GBK-com/Delumenyu/小型偏心柱塞泵/FINAL_REPORT.md

# 小型偏心柱塞泵 —— 最终交付报告

2026-11-02 12:30 · Lead + 4 个子智能体并行交付
（本文件取代 `DELIVERY.md`，是最新且唯一有效的交付说明）

---

## 一、总览：全部完成

| 交付项 | 状态 |
|---|---|
| SolidWorks 零件建模（8 类） | ✅ **完成**，逐件体积/包围盒/关键面实测回读 |
| 完整装配（16 组件） | ✅ **完成**，三柱塞位置与运动学表逐位吻合 |
| 干涉检查 | ✅ **完成**，真设计干涉 **0 项** |
| 运动仿真 | ✅ **完成**，SW 原生 Motion Study 已求解 |
| AutoCAD 全套工程图（4 张） | ✅ **完成**，每张 finalize 92 分/B，回归 48/48 全绿 |

---

## 二、液力参数（设计值）

3 柱塞径向 120° 均布 · 柱塞 Ø12 · 偏心 e₁=2.5 → 行程 **5.000** · 排量 **1.696 mL/r**（对外 1.70）
n=1450 r/min → 理论流量 **2.460 L/min** · 额定 10 MPa · 轴功率 **0.482 kW**（配 0.55 kW）
流量脉动系数 δq ≈ **7.18%** · 外形 **Ø104 × 74**

---

## 三、零件清单（全部实测，sha256 前 16 位）

| 件号 | 名称 | 体积 mm³ | box mm | sha256 | 关键实测 |
|---|---|---|---|---|---|
| BP-01 | 泵体 ZL104 | 376,159.161523 | Ø104×56 | `63d0b4d7e82e2d92` | 3×Ø12.5@0/120/240→R48；3×Ø5@R26；2×M14@90°/270° z=40；6×M5 Ø4.2@Ø88 深16；1° 拔模；40 特征 0 错 |
| BP-02 | 偏心轴 45调质 | 26,474.290684 | 25.7×24×93 | `04f4e2ee92059c4a` | e₁ 实测 +2.500 / e₂ 实测 −1.200；两键槽 4×2.5；退刀槽 Ø13×2；37 特征 0 错 |
| BP-03 | 柱塞 GCr15 | 2,462.415505 | 12×12×29 | `ced2dc057a3f3ab5` | 球头 R5 + Ø12×18 + 环槽 Ø8.6×2.4 + Ø8×6 |
| BP-03b | 柱塞（装配朝向版） | 2,467.116843 | 12×12×29 | `2885eeb2f4f376e2` | **同一零件的另一种朝向**，用于配合定向；明细栏仍是一项 ×3 |
| BP-04 | 回程盘 45 | 46,957.427426 | 104×104×10.089 | `f8ecf160c09274e0` | 球冠 R40（r10 处凸 4.0888）；3×沉头 Ø5.5/Ø10@Ø88 + 3×Ø5.5 通孔@Ø88；槽 Ø70×3.8×2.4 |
| BP-05 | 配流盘 ZQSn6-6-3 | 19,501.866475 | 64×64×10 | `cf532b0a3cdabb11` | 腰型窗内R22.5/外R29.5、包角160°×2、岛20°×2 岛跨±X；Ø21×1 沉孔 |
| BP-06 | 端盖 ZL104 | 93,469.858619 | 104×104×12 | `eacee309a32b9b47` | Ø16H7；6×Ø5.5@Ø88；槽 Ø70×3.8×2.4；凹球座 R40 深 4.0888 |
| BP-07 | 弹簧 60Si2Mn | 284.244607 | 11.2×11.2×17 | `84ebdc55cac4f5b0` | 线径Ø1.2、中径Ø10、总圈8/有效6、自由长17、安装长13 |
| STD | O型圈67×3 | 1,554.462693 | 73×73×3 | — | 中径 Ø70 |
| STD | O型圈10×1.8 | 94.333679 | 13.6×13.6×1.8 | — | 柱塞密封 |
| STD | 螺钉M5×20 / M5×30 | 631.603273 / 827.952814 | — | — | 等效件 |

---

## 四、装配与干涉

**`PUMP_ASSY.sldasm`**（312,627 B，sha `5379e202bac9fc57`）—— 16 组件完整总装
**`PUMP_MOTION_study.sldasm`**（219,014 B，sha `036da6b8006b3b2f`）—— 运动版（凸轮耦合 + 旋转马达）

### 三柱塞位置 vs 运动学表（θ=0）
| 柱塞 | 实测 ρ | 实测方位 | 运动学期望 | 判定 |
|---|---|---|---|---|
| 0° | 19.500 | 0° | 19.500 | ✔ |
| 120° | 15.750 | 120° | 15.750 | ✔ |
| 240° | 15.750 | 240° | 15.750 | ✔ |

### 干涉检查：9 项，**真设计干涉 0**
| 项 | 体积 mm³ | 判定 |
|---|---|---|
| 3×M5×30 vs 泵体 | 279.53 | 螺纹名义干涉（等效件光杆 Ø5 进 Ø4.2 底孔），CAD 常规 |
| 3×M5×20 vs 泵体 | 221.40 | 同上 |
| O型圈67×3 ×2 vs 沟槽 | 221.32 | 设计压缩 0.6 mm，正常 |
| 回程盘 vs 端盖 | 0.005 | 球面座接触，可忽略 |

### 运动仿真
`MCP_旋转马达算例` · AEMRotationalMotor · 60 rpm · 时长 4.0 s · 马达 1 · **results_available=true, out_of_date=false**
运动版装配体干涉检查 **0 项**，球头相切于偏心轮（球心 ρ=19.5、球头最内点 14.5 = 凸轮表面）。
**在 SolidWorks 里打开 `PUMP_MOTION_study.sldasm`，切到「运动算例」点播放即可看到柱塞往复。**

---

## 五、工程图（4 张，全部 92 分/B，0 error）

| 图 | 图幅 | DWG / DXF / PDF | 真实尺寸 | 内容 |
|---|---|---|---|---|
| BP-00 装配图 | A1 1:1 | 48,688 / 349,764 / 160,244 | 5 | 主视图 + A-A 全剖（24 处真实 HATCH）+ 配流原理图 + 明细栏 12 行原生 TABLE + 11 项序号 + 技术要求原文 5 条 + 追加 2 条 |
| BP-01 泵体 | A3 1:1 | 30,721 / 159,300 / 125,662 | 10 | 主+俯+B-B 全剖，7 处剖面线，6 形位公差，Ra0.8×2/Ra3.2 |
| BP-02 偏心轴 | A3 1:1 | 29,157 / 156,902 / 123,082 | **18** | 9 段阶梯 + 两键槽 + 退刀槽 + 键槽断面 + 偏心轮端视图；**e=2.5±0.02 用真公差**（DIMTOL/DIMTP/DIMTM） |
| BP-05 配流盘 | A3 2:1 | 32,879 / 157,348 / 63,654 | 9 | 腰型窗真实 ARC（R22.5/R29.5、160°/20°）+ 剖视 + 5 形位公差 + Ra0.4 |

图层按 8 层规范（01轮廓粗/02轮廓细/03中心线/04虚线/05标注/06文字/07剖面线/08图框标题栏）
回归校验 `cad/verify_drawings.py`：**48 项通过 / 0 失败**

---

## 六、设计过程中查出并修掉的 12 条真缺陷

| # | 缺陷 | 后果 | 谁发现 |
|---|---|---|---|
| 1 | 中心腔 Ø30 装不下 Ø40 回程盘 | 装配装不进 | Lead |
| 2 | 配流孔 R19 落在 Ø44 腔壁内 | 泵不打油 | Lead |
| 3 | **配流窗 110°/70° 布局** | 120°/240° 柱塞**中途换向→憋压** | Lead（相位校验） |
| 4 | 端盖 Ø88 槽与 Ø92 螺栓孔重叠 2.55 | 六处破口 | sub-cad |
| 5 | **弹簧 Ø1.6/8圈 压并 16.96 > 最小工作 10.5** | **行程一半压死** | Lead（刚度校核） |
| 6 | **轴装回程盘几何无解** | 中心孔需 ≥Ø30 过凸轮，但沉头孔只能在 R9 拧进 Ø24 轮 | sub-rotor + sub-plunger 独立发现 |
| 7 | 偏心轮端面 M4 破出外圆 0.126 | 螺纹破口 | sub-rotor |
| 8 | **M5 底孔与油口同方位贯通** | 压力油窜入螺钉孔外漏 | sub-housing（−139.15 mm³ 定量） |
| 9 | **回程盘 Ø78 槽与自身沉头孔重叠 1.9** | 密封带被打穿 | sub-housing 提线索 + sub-plunger 五级印证 |
| 10 | **偏心轴 Ø20 伸进配流盘 Ø16.5 孔** | 86.805 mm³ 真干涉 | Lead（干涉检查） |
| 11 | 回程盘只有 3 孔、端盖 6 螺栓 | 3 颗螺钉穿实心铝 | Lead（装配发现） |
| 12 | 图纸柱塞按 ρ=17 画 | 球头插进偏心轮 2.5 mm（自绘干涉） | sub-cad |

---

## 七、偏差登记（详见 `DEVIATIONS.md`，共 13 条 + 本轮新增）

- **弹簧为 8 圈环形叠片，非真螺旋**：扫描内核不支持螺旋路径（`cad_sweep` 直管精确 22.62，1 圈螺旋仅 0.16 mm³；`cad_loft` 报 sections too dissimilar；FreeCAD 未安装）。**本地 SW 手工扫掠一次即可替换**，参数在 `DESIGN_SPEC.md §3.7`。
- **装配体中未绘出 3 个弹簧**：环形件无圆柱面，桥接器 `rotate` 失效无法定向。明细栏仍列 ×3，装配图已加声明。
- **SW 模型未赋材料**：桥接器无接口，`mass_kg` 无工程意义，材料走明细栏。
- **回程盘功能重定位**为壳体上端封压盘（轴装几何无解）。
- **客户技术要求第 1 条**「配流盘与柱塞球面配合面研磨」原文照抄，但本设计为端面配流、两者无直接配合面——**若客户本意是别的结构型式，需回退重议**。
- **注**：`pump\` 目录下 `BP01_housing_v2`、`BP06_endcover_v2`、`BP04_retainer_v2`、`BP05_portplate_v3`、`STD_oring_75x3`、`STD_screw_M4x10` 均为**过期中间件**，沙箱无删除权限，请手动清理。

---

## 八、文件清单

```
deliver/
├── sw/    15 个：8 类零件 + 柱塞装配朝向版 + 弹簧安装态 + 4 标准件 + 2 装配体
├── cad/   12 个：4 张图 × (DWG+DXF+PDF) + verify_drawings.py
└── doc/   DESIGN_SPEC.md(v1.3) / DEVIATIONS.md / KINEMATICS.md /
           portplate_geometry.md / RESULT_{housing,plunger,rotor,cad}.md
```

---

## 九、仍需客户拍板的两件事

1. **结构型式**：本设计为「径向柱塞 + 随轴旋转端面配流盘」。若原意是轴向柱塞（斜盘式）或其他型式，整套要重做。
2. **回程盘重构**是否接受（轴装几何无解 → 改壳体上端封压盘）。
