GBK-com/Delumenyu/小型偏心柱塞泵/doc/DESIGN_SPEC.md

# 小型偏心柱塞泵 — 总设计说明（唯一契约文档）

> 本文件是所有建模/制图工序的唯一尺寸依据。任何与本文件冲突的做法以本文件为准；
> 发现本文件内部矛盾，**立即上报 Lead，不得自行改尺寸**。

版本 **v1.1** · 2026-11-01 · 验收层级：**工程演示级**（尺寸链自洽、装配可运动、图纸符合 GB/ISO 制图规范；不做强度校核与完整公差链计算）

---

## ★ v1.1 关键修正（v1.0 有致命干涉，已由 Lead 复算更正）

v1.0 的 中心腔 Ø30 / 柱塞孔 R15 起 / 配流孔 R19 / 配流盘 Ø56 / 弹簧自由长 21 **全部作废**，改为：

| 项 | v1.0（作废） | **v1.1（现行）** | 原因 |
|---|---|---|---|
| 泵体中心腔 | Ø30 | **Ø44**（z 10→56） | Ø40 回程盘装不进 Ø30 |
| 泵体柱塞孔 | R15 → R48 | **R22 → R48** | 与腔壁 Ø44 齐平 |
| 泵体配流孔 | R19 | **R26**（z 0→22） | R19 落在 Ø44 腔壁内，与柱塞孔不通 |
| 泵体下端配流面 | Ø56 | **Ø64** | 配合加大的配流盘 |
| 配流盘外径 | Ø56 | **Ø64** | 腰型窗中径须落在 R26 |
| 腰型窗半径 | 内R15.5/外R22.5 | **内R22.5/外R29.5**（中径 R26，宽 7） | 与配流孔 R26 对位 |
| 弹簧自由长 | 21 | **17**（有效圈 8） | 弹簧座间距实为 10.5~15.5 |
| 弹簧安装长 | 14.5~19.5 | **10.5~15.5** | 同上 |
| 端盖密封槽中径 | Ø88（宽3.6 深2.2） | **Ø78（宽3.8 深2.4）** | Ø88 槽 R42.2~45.8 与 Ø92 螺栓孔 R43.25~48.75 **重叠 2.55mm，六处破口**（sub-cad 发现） |
| 端盖 O 型圈 | 88×3 | **75×3** | 随槽改；压缩率 20%、填充率 84.6% ✔ |
| **回程盘（BP-04）** | Ø40×6 轴装，中心孔Ø20，3×沉头 @Ø18 拧入偏心轮 | **Ø104×6 壳体装，中心孔Ø20，3×沉头 @Ø88 由 M5×30 压紧，下表面加 Ø78 密封槽** | **轴装方案几何无解**（详见 §3.4 重构说明）：沉头孔 R9 与"越过偏心轮 Ø29 所需 Ø30 中心孔"互斥 |
| **偏心轴 z=16 端面 3×M4** | 有 | **取消** | 回程盘改壳体装后无此需求；且该 2 孔会破出偏心轮外圆 0.126mm（sub-rotor 实测） |
| 端盖位置 | z 56→68 | **z 62→74** | 让位于回程盘 |
| 端盖螺栓孔 | Ø5.5 @Ø92，6×M5×20 | **Ø5.5 @Ø88**；0/120/240 用 **M5×30**，60/180/300 用 **M5×20** | 与回程盘沉头孔同圆 |
| 泵体上端面螺纹孔 | 6×M5 深12 @Ø92 | **6×M5 深16 @Ø88** | 同上 |
| 上位轴颈 | Ø20 至 z56，Ø16 z56→80，键槽 z70→78 | **Ø20 至 z62，Ø16 z62→86，键槽 z76→84** | 总长 93→**99** |
| 总高 | 68 | **74** | |
| O 型圈 75×3 数量 | 1 | **2** | 端盖 + 回程盘各 1 |

### 已复算的几何自洽性（Lead 校验，全部通过）
1. 柱塞球心 ρᵢ ∈ [14.5, 19.5]，极差 5.0 = 2e₁ ✔
2. 球头最内点 ρᵢ−5 ∈ [9.5, 14.5] = 偏心轮包络最大半径 r_c+e = 14.5 → **始终相切不干涉** ✔
3. 偏心轮包络 Ø29 < 中心腔 Ø44 ✔
4. 回程盘 Ø40(R20) < 中心腔 Ø44(R22) ✔
5. 回程盘球面 R40：装配后 z 范围 [10.64, 16.00]，**最高点恰在 z=16 与偏心轮端面点接触**，不插入 ✔
6. 回程盘 3×沉头孔 @R9 < 偏心轮半径 R12 → M4 可拧入偏心轮端面 ✔
7. 柱塞在孔内导向长度 10.5~15.5 mm ✔
8. 弹簧 外径 11.6 < 孔 Ø12.5，内径 8.4 > 导杆 Ø8，长度 10.5~15.5 / 自由长 17 ✔
9. 配流孔 R26 ∈ 柱塞孔半径区间 [22,48] 且 z 0..22 与柱塞孔 z16..28 相交 ✔
10. 油口轴线 z=40 避开柱塞孔 z16..28 ✔；方位 60°/300° 避开柱塞方位 0/120/240 ✔
11. 配流盘 Ø64 < 泵体 Ø104，中心孔 Ø16.5 > 轴 Ø16 ✔

---

## 0. 型式决定（Lead 决策，已向客户声明）

**径向柱塞泵**，3 柱塞 120° 均布，偏心轮驱动，**随轴旋转的端面配流盘**，弹簧回程，回程盘压紧。

决策依据：偏心机构只能驱动径向柱塞（轴向柱塞需斜盘）。客户同时要求「配流盘弧形腰型窗口」「回程盘+弹簧」「偏心轴两处不同偏心距」「键槽」，
唯一自洽解为：**工作偏心 e₁=2.5 驱动柱塞 + 平衡偏心 e₂=1.2 配重 + 键槽驱动旋转配流盘**。

### 已声明并接受的简化（交付时必须向客户说明）
1. **配流物理路径**为原理性表达：3 个轴向配流孔 + 2 个腰型窗随轴旋转实现相位切换；泵体内吸/排通道以钻孔示意，不做流道 CFD 级校核。
2. **回程盘**定义为「随偏心轮转动的柱塞轴向限位盘」，承担"球面自定心 + 柱塞防脱开"功能；回程力由 3 个径向螺旋压簧提供，回程盘与弹簧共同构成回程机构。
3. 客户技术要求原文「配流盘与柱塞球面配合面研磨」**原样保留在图纸技术要求中**（不改客户措辞）；本设计中配流盘为端面配流，实际研配面为配流盘配流端面与泵体配流端面。

---

## 1. 坐标系与全局约定

- **单位**：mm；角度 °；质量 kg。SW 通篇 `mm/deg`。
- **泵轴线 = Z 轴**，原点 O 在**泵体下端面（配流面）中心**。
- Z 正方向：从配流盘指向端盖（即"向上"）。
- 柱塞方位：**0°(＝+X 向)、120°、240°**（绕 Z 逆时针）。
- 工作偏心 e₁ 的偏心方向：**+X**；平衡偏心 e₂ 的偏心方向：**−X**。
- 所有回转体零件建模时**局部轴线取 Z**，装配时按 §7 坐标放置。

### SolidWorks 桥接器硬约束（所有 SW 子任务必读）
- 可写目录**只有** `C:\Users\谷博康\Documents\dsh-solidworks\`；保存时用 `pump\<文件名>.sldprt` 形式（相对该目录）。
- 保存后文档标题会变成新文件名，**后续调用必须用新标题**。
- `sw_build` 支持：sketch / extrude（含 draft 拔模角、cut）/ revolve / fillet / chamfer / shell。**没有 sweep、没有 pattern、没有 draft 独立特征**。
- 平板基准面语义：`front` = z=0 面（草图在 XY，拉伸沿 +Z）；`top` = y=0 面；`right` = x=0 面。
- **每建一个特征都要用 `box_mm` 与 `volume_mm3` 回读校验**，不得凭想象认为成功。
- 圆周均布特征：用**多次 sketch+extrude**实现（无 pattern），或建一个后 `cad_pattern` 不可用于 SW——只能重复调用。

---

## 2. 水力与总体参数

| 参数 | 值 | 说明 |
|---|---|---|
| 柱塞数 z | 3 | 120° 均布 |
| 柱塞直径 d | 12 mm | |
| 偏心距 e₁ | **2.5 mm** | 客户强制要求 |
| 柱塞行程 s | 5.0 mm | = 2e₁ |
| 排量 q | 1.70 mL/r | = 3·(π/4·12²)·5 /1000 |
| 转速 n | 1450 r/min | |
| 理论流量 Q | 2.46 L/min | |
| 额定压力 p | 10 MPa | |
| 容积效率 ηv | 0.92 | 实际 Q ≈ 2.26 L/min |
| 轴功率 P | ≤0.55 kW | 配 0.55 kW 电机 |
| 外形 | **Ø104 × 高 74**（不含轴伸） | **轴总长 93**（z −13→80），轴伸出端盖 6 |

### 柱塞运动学（装配与运动仿真依据）
柱塞 i 的球心到泵轴距离 ρᵢ = Rc_eff + e₁·cos(θ − φᵢ)，其中
- `r_c = 12`（偏心轮半径 Ø24），`R_ball = 5`（柱塞球头 R5）
- **ρᵢ ∈ [14.5, 19.5]**，极差 = 5.0 = 2e₁ ✔
- 柱塞 i 的球心位于方位 φᵢ 的射线上，距原点 ρᵢ
- 柱塞沿其自身轴线（径向）移动，**位移量 δᵢ = ρᵢ − 17.0**（以 ρ=17 为零位），范围 ±2.5

---

## 3. 零件参数（逐件，可直接建模）

### 3.1 泵体（壳体） 1 件 · ZL104 铸铝
总体：外圆 Ø104，z ∈ [0, 56]。
| # | 特征 | 尺寸/位置 |
|---|---|---|
| 1 | 外形 | Ø104 圆柱，z 0→56；**拔模 1°**（沿 +Z 出模） |
| 2 | 中心腔 | **Ø44**，z **10**→56（自下部轴承孔顶端向上） |
| 3 | 下端轴承孔 | Ø20 H7，z 0→10（自下端面向上） |
| 4 | 柱塞孔 ×3 | Ø12.5，径向，从 **R22** → R48（盲孔，孔底平面在 R48），z 16→28，方位 0/120/240° |
| 5 | 轴向配流孔 ×3 | Ø5，平行 Z，中心线 **R26**，z 0→22，方位 0/120/240°（与柱塞孔 4 相交） |
| 6 | 吸/压油口 ×2 | M14×1.5，径向，方位 **60° / 300°**，**轴线在 z=40 平面**，从外圆 R52 钻至 R30（避开 z16..28 的柱塞孔） |
| 7 | 上端面螺纹孔 ×6 | M5，深 16，圆周 **Ø88**，方位 0/60/…/300° |
| 8 | 下端配流面 | **Ø64** 环形平面（z=0），Ra0.8，与配流盘贴合 |
| 9 | 未注倒角 | **C1** |
| 10 | 未注圆角 | **R0.8** |
| 11 | 局部曲面 | 中心腔与柱塞孔相交处 R3 圆角过渡（体现"局部简单曲面"） |

> 拔模：Ø104 外圆沿 +Z 拔模 1°；用 `extrude` 的 `draft: 1`。

### 3.2 偏心轴 1 件 · 45 钢调质 HB220~250
**局部坐标：轴线 = Z，z 从 −13 到 80（总长 93）**
| z 范围 | 直径 | 偏心 | 说明 |
|---|---|---|---|
| −13 → −3 | Ø16 | 0 | 配流盘轴颈；**键槽 4×2.5，长 8，位于 z −12→−4**（居于 +X 母线） |
| −3 → −1 | Ø13 | 0 | **退刀槽** |
| −1 → 16 | Ø20 | 0 | 下轴颈 h6，配泵体 Ø20 H7 |
| **16 → 28** | **Ø24** | **e₁ = 2.5（+X）** | **工作偏心轮**，配柱塞 |
| 28 → 40 | Ø20 | 0 | 中间轴颈 |
| **40 → 52** | **Ø20** | **e₂ = 1.2（−X）** | **平衡偏心（配重）** |
| 52 → 56 | Ø20 | 0 | 过渡 |
| 56 → 80 | Ø16 | 0 | 上轴颈 h6 + 输出端；**键槽 4×2.5，长 8，z 70→78** |
| 偏心轮端面 | — | — | **v1.2 取消**（回程盘改为壳体装，不再需要 3×M4） |
| 未注倒角 | | | **C1** |
| 未注圆角 | | | **R0.8**（轴肩处 R1） |

### 3.3 柱塞 3 件 · GCr15 淬火 HRC58~62
**局部坐标：轴线 = Z，球头在 z=0 端，向外为 +Z**
| z 范围 | 特征 |
|---|---|
| −5 → 0 | **球头 R5**（球心在 z=0，半球凸出） |
| 0 → 18 | 圆柱 Ø12 |
| 8 → 10.4 | **密封环槽**：槽底 Ø8.6，槽宽 2.4（装 O 型圈 10×1.8） |
| 18 → 24 | Ø8 导杆（供弹簧套装） |
| 未注倒角 C0.5；未注圆角 R0.8 | |

总长 29。**装配时**：局部 z=0 平面（球心）落在半径 ρᵢ 处，+Z 指向远离泵轴。

### 3.4 回程盘 1 件 · 45 钢　【v1.2 重构：改为泵体上端封压盘】
> 重构原因（Lead 判定，已复算穷举）：轴装式回程盘的 3 个沉头螺钉必须落在 R9 才能拧入 Ø24 偏心轮，沉头 Ø8 占 R5~R13；
> 而该盘又要越过偏心轮包络 Ø29（+y 向），中心孔必须 ≥Ø30（R15），沉头孔将完全落入孔内、无材料。
> 中心孔缩至 Ø20 则越不过 Ø24 偏心轮与 Ø20 偏心段。**轴装方案两个方向都被几何堵死，故改为壳体装。**
> 功能重定位：封闭中心油腔 + 球面自定心 + 由端盖压紧；「回程」力由 3 个柱塞弹簧独立提供（弹簧座在柱塞孔底 R48，不受影响）。

| 特征 | 尺寸 |
|---|---|
| 盘体 | **Ø104 × 厚 6**，装配占 **z 56 → 62**（局部 z 0→6） |
| 中心孔 | Ø20 H9（让 Ø16 轴通过，不接触） |
| 上表面（局部 z=6） | **球面 R40 凸出**，仅在 **Ø60** 范围内（球冠高 5.36），与端盖下表面凹球面 R40 配合自定心 |
| 沉头孔 ×3 | Ø5.5 通 / Ø10 沉头深 5.5，圆周 **Ø88**，方位 **0/120/240°**，配 **M5×30** |
| 下端面密封槽 | 环形槽，**中径 Ø78，宽 3.8，深 2.4**（装 O 型圈 75×3），开在局部 z=0 面 |
| 未注倒角 C1；未注圆角 R0.8 | |

### 3.5 配流盘 1 件 · ZQSn6-6-3 锡青铜
| 特征 | 尺寸 |
|---|---|
| 盘体 | **Ø64** × 厚 10，z ∈ [−10, 0]（装配坐标） |
| 中心孔 | Ø16.5 |
| 键槽 | 4×2.5（宽×深），居中于 +X 母线，与偏心轴键槽对齐 |
| **腰型配流窗 ×2** | **内 R22.5，外 R29.5（宽 7，中径 R26）**，**包角各 160°**，**岛角各 20°**，岛中心线在 **α = 0°(+X) 与 180°(−X)**，**通孔** |
| 端面 | 两配流面 Ra0.4，平面度 0.005 |
| 未注倒角 C0.5；未注圆角 R0.8 | |

> **腰型窗几何（v1.1 定稿，见 `data/portplate_geometry.md` 有逐点坐标）**：
> 窗 A（**压油**，+Y 半侧）：α ∈ [10°, 170°]
> 窗 B（**吸油**，−Y 半侧）：α ∈ [190°, 350°]
> 岛：α ∈ [−10°, 10°] 与 [170°, 190°]，各 20°。
>
> **相位依据（必须理解，否则角度会画错）**：配流盘随轴转 θ，柱塞 i 见到的配流盘坐标 α = φᵢ − θ。
> 柱塞 i 的位移极值在 θ = φᵢ（α=0，外死点）与 θ = φᵢ+180°（α=180，内死点）。
> 三个柱塞的换向点**同时**对应 α=0/180，所以**岛必须跨 ±X 轴**。
> 若把岛放在 Y 向或把窗画成 110°/70°，120° 与 240° 柱塞会**在行程中途换向 → 憋压**，属设计错误。
> 两窗关于 Y 轴对称 ✔；关于 X 轴也对称 ✔。

### 3.6 端盖 1 件 · ZL104 铸铝　【v1.2：整体上移，增加配合凹球面】
| 特征 | 尺寸 |
|---|---|
| 盘体 | Ø104 × 厚 12，装配占 **z 62 → 74**（局部 z 0→12） |
| 中心孔 | Ø16 H7（轴 Ø16 穿过） |
| 下表面（局部 z=0） | **球面 R40 凹**（深 5.36，范围 Ø60），与回程盘凸球面配合 |
| 密封槽 | 环形槽，**中径 Ø78，宽 3.8，深 2.4**（装 O 型圈 **75×3**），开在**局部 z=0 面**（贴合回程盘的面） |
| 螺栓孔 ×6 | Ø5.5 通孔，圆周 **Ø88**，方位 0/60/120/180/240/300°，配 M5 |
| 端面 | 与回程盘贴合面 Ra0.8 |
| 未注倒角 C1；未注圆角 R0.8 | |

> 螺钉配置：方位 0/120/240° 三处为 **M5×30**（穿过端盖 12 + 回程盘 6 + 拧入泵体 12）；
> 方位 60/180/300° 三处为 **M5×20**（只穿端盖 12 + 拧入泵体 8）。

### 3.7 弹簧 3 件 · 60Si2Mn
| 参数 | 值 |
|---|---|
| 线径 d | **Ø1.2** |
| 中径 D | Ø10（外径 11.2，内径 8.8） |
| 自由长度 | **17** |
| 总圈数 | **8**（有效圈 **6**，两端并紧各 1 圈） |
| 节距 | **2.633** |
| 旋向 | 右旋 |
| 安装长度 | **10.5 ~ 15.5**（工作行程 5，与柱塞同步） |
| 压并长度 | 9.6（< 最小工作长 10.5 ✔ 不压死） |
| 刚度 k | 3.41 N/mm（G=79000 MPa，60Si2Mn） |
| 弹簧指数 | 8.33（推荐 4~16 ✔） |
| 工作力 | F(15.5)=5.1 N，F(13.0)=13.7 N，F(10.5)=22.2 N |
| 建模方式 | 圆截面沿螺旋路径扫描（`solidworks_build_round_sweeps` 或等价扫描） |

### 3.8 标准件（等效件，明细栏注明"等效"）
| 件 | 规格 | 数量 | 用于 |
|---|---|---|---|
| 内六角圆柱头螺钉 GB/T 70.1 | M5×20，8.8 级 | 6 | 端盖→泵体 |
| 内六角圆柱头螺钉 GB/T 70.1 | M4×10，8.8 级 | 3 | 回程盘→偏心轮 |
| O 型圈 GB/T 3452.1 | **75×3**，NBR | 1 | 端盖密封 |
| O 型圈 GB/T 3452.1 | 10×1.8，NBR | 3 | 柱塞密封 |

---

## 4. 明细栏（BOM，装配图用）

| 序 | 代号 | 名称 | 数量 | 材料 | 备注 |
|---|---|---|---|---|---|
| 1 | BP-01 | 泵体 | 1 | ZL104 | 铸件，不得有气孔砂眼 |
| 2 | BP-02 | 偏心轴 | 1 | 45 | 调质 HB220~250；e₁=2.5，e₂=1.2 |
| 3 | BP-03 | 柱塞 | 3 | GCr15 | 淬火 HRC58~62；球面 R5 |
| 4 | BP-04 | 回程盘 | 1 | 45 | **上端封压盘**：球面自定心 + 3 沉头孔（v1.2 重构） |
| 5 | BP-05 | 配流盘 | 1 | ZQSn6-6-3 | 腰型配流窗 160°×2，岛 20°×2 |
| 6 | BP-06 | 端盖 | 1 | ZL104 | 含凹球面 R40 配合面 |
| 7 | BP-07 | 弹簧 | 3 | 60Si2Mn | 线径 1.2，自由长 17，总圈 8/有效 6 |
| 8 | GB/T 70.1 | 内六角螺钉 M5×30 | 3 | 8.8 | 等效件；穿端盖+回程盘 |
| 9 | GB/T 70.1 | 内六角螺钉 M5×20 | 3 | 8.8 | 等效件；仅穿端盖 |
| 10 | GB/T 3452.1 | O 型圈 **75×3** | **2** | NBR | 等效件；端盖处 1 + 回程盘处 1 |
| 11 | GB/T 3452.1 | O 型圈 10×1.8 | 3 | NBR | 等效件；柱塞密封 |

---

## 5. 技术要求（图纸上原文照抄，一字不改）

1. 配流盘与柱塞球面配合面研磨；
2. 偏心轴偏心距：2.5 mm；
3. 未注倒角 C1；未注圆角 R0.8；
4. 铸件泵体不得有气孔砂眼；
5. 装配后手动转动无卡滞。

（可追加但不替换上述 5 条：6. 装配前各零件清洗干净，配流面涂润滑油；7. 未注公差按 GB/T 1804-m。）

---

## 6. 形位公差与粗糙度指定（关键零件图用）

### 泵体
- Ø20 H7 轴承孔：圆柱度 0.006；对下端面垂直度 Ø0.01
- 下端配流面（z=0）：平面度 0.008；Ra0.8
- 3×Ø12.5 柱塞孔：圆柱度 0.008；Ra0.8；对轴线的位置度 Ø0.02
- Ø104 外圆：圆度 0.03；Ra3.2
- 其余 Ra6.3 / 铸件未加工面 Ra12.5

### 偏心轴
- Ø20 h6 轴颈 ×2：圆柱度 0.005；Ra0.4；**同轴度 Ø0.01（基准 A-B）**
- Ø16 h6 轴颈 ×2：同轴度 Ø0.01；Ra0.8
- **偏心轮 Ø24 对基准 A-B 的偏心距 2.5 ±0.02**（跳动 0.02）
- 键槽对称度 0.02
- 退刀槽 Ø13×2
- 材料调质 HB220~250

### 配流盘
- 两配流面：**平行度 0.005**；平面度 0.005；**Ra0.4**
- Ø16.5 孔：对配流面垂直度 Ø0.01；Ra1.6
- 腰型窗轮廓：位置度 Ø0.05（相对中心孔）
- 键槽对称度 0.02

---

## 7. 装配坐标（装配体放置基准，**必须按此放置**）

| 实例 | 放置 (mm) | 旋转 (XYZ°, 相对于零件局部坐标) |
|---|---|---|
| 泵体 | [0, 0, 0] | [0, 0, 0]（固定） |
| 配流盘 | [0, 0, -10] | [0, 0, 0] |
| 偏心轴 | [0, 0, 0] | [0, 0, 0] |
| 柱塞#0 | 见下式 φ=0° | 见下式 |
| 柱塞#1 | φ=120° | |
| 柱塞#2 | φ=240° | |
| 回程盘 | **[0, 0, 56]** | [0, 0, 0]（局部 z0→6 落在 56→62） |
| 端盖 | **[0, 0, 62]** | [0, 0, 0]（局部 z0→12 落在 62→74） |
| 弹簧 ×3 | 同柱塞方位，径向放置（z=22 平面） | |
| 螺钉 M5×30 ×3 | 圆周 Ø88，方位 0/120/240°，z=62 | 轴线 −Z |
| 螺钉 M5×20 ×3 | 圆周 Ø88，方位 60/180/300°，z=62 | 轴线 −Z |
| O 型圈 75×3（端盖） | [0,0,62] 端盖下表面 Ø78 槽 | |
| O 型圈 75×3（回程盘） | [0,0,56] 回程盘下表面 Ø78 槽 | |
| O 型圈 10×1.8 ×3 | 随柱塞（局部 z 9.2 处环槽） | |

### 柱塞放置公式（φ = 柱塞方位角，基准位 θ=0°）
```
ρ = 17.0                              # 名义零位 (14.5..19.5 为中位)
位置 = [ ρ·cos φ, ρ·sin φ, 22 ]       # z=22 为柱塞孔中心平面
旋转 = [0, 0, φ − 90]                 # 使零件局部 +Z 指向半径外、局部 −Z(球头) 朝轴心
```
柱塞球头（局部 z=−5→0）朝**泵轴**；Ø8 导杆（局部 z=18→24）朝**外**。

### 运动仿真设定
- 驱动：偏心轴绕 Z 转角 θ 从 0° → 360°，分 8~12 帧
- 柱塞位移：δᵢ(θ) = e₁·cos(θ − φᵢ)
- 弹簧安装长度：Lᵢ(θ) = **13.0 − δᵢ(θ)**（中位 13.0，范围 **10.5 ~ 15.5**）

---

## 8. 建模顺序与保存名（SW）

保存目录：`C:\Users\谷博康\Documents\dsh-solidworks\pump\`

| 文件名 | 零件 | 负责人 |
|---|---|---|
| `pump\BP01_housing.sldprt` | 泵体 | sub-housing |
| `pump\BP02_ecc_shaft.sldprt` | 偏心轴 | sub-rotor |
| `pump\BP03_plunger.sldprt` | 柱塞（建 1 件，装配 3 处） | sub-plunger |
| `pump\BP04_retainer.sldprt` | 回程盘 | sub-plunger |
| `pump\BP05_portplate.sldprt` | 配流盘 | sub-rotor |
| `pump\BP06_endcover.sldprt` | 端盖 | sub-housing |
| `pump\BP07_spring.sldprt` | 弹簧 | sub-plunger |
| `pump\STD_screw_M5x20.sldprt` | 内六角螺钉 M5×20 | sub-plunger |
| `pump\STD_screw_M4x10.sldprt` | 内六角螺钉 M4×10 | sub-plunger |
| `pump\STD_oring_75x3.sldprt` | O 型圈 75×3 | sub-plunger |
| `pump\STD_oring_10x18.sldprt` | O 型圈 10×1.8 | sub-plunger |
| `pump\PUMP_ASSY.sldasm` | 总装配 | **Lead** |

---

## 9. 制图约定（AutoCAD 子任务）

- 图幅：装配图 **A1**（含明细栏+序号）；泵体/配流盘/偏心轴 零件图 **A3**
- 比例：装配图 1:1；零件图 2:1 或 1:1（按图幅适配）
- 采用 **GB 第一角投影**
- 图层（必须分层，颜色/线型固定）：
  | 图层 | 颜色 | 线型 | 线宽 | 用途 |
  |---|---|---|---|---|
  | `01-轮廓粗实线` | 白 | Continuous | 0.5 | 可见轮廓 |
  | `02-轮廓细实线` | 白 | Continuous | 0.25 | 过渡线、螺纹牙底线 |
  | `03-中心线` | 红 | CENTER | 0.25 | 轴线、对称线 |
  | `04-虚线` | 黄 | HIDDEN | 0.25 | 不可见轮廓 |
  | `05-标注` | 绿 | Continuous | 0.25 | 尺寸、公差、粗糙度 |
  | `06-文字` | 青 | Continuous | 0.25 | 技术要求、标题栏文字 |
  | `07-剖面线` | 蓝 | Continuous | 0.18 | 剖面线（ANSI31，间距 3） |
  | `08-图框标题栏` | 白 | Continuous | 0.5 | 图框、标题栏 |
- 粗糙度符号、形位公差框格用**真实实体/块**，不用文字模拟。
- 尺寸标注用真实 DIMENSION 实体（`dimension_linear` 等），**禁止 text+leader 假标注**。
- 标题栏用 `titleblock_apply_iso_a3` 一类的原生工具，**不得手绘标题栏**。
