GBK-com/Delumenyu/小型偏心柱塞泵/DELIVERY.md

# 小型偏心柱塞泵 — 交付说明（含未完成项，如实登记）

生成时间：2026-11-01 23:20　│　执行方式：Lead + 4 个子智能体并行（sub-housing / sub-rotor / sub-plunger / sub-cad）

---

## 一、先给结论（诚实版）

| 交付项 | 状态 | 说明 |
|---|---|---|
| 8 类零件三维建模 | ✅ **完成** | 全部落盘，逐件体积/包围盒/关键面实测回读，sha256 留档 |
| 装配体 | ⚠️ **部分完成** | 壳体/轴/配流盘/回程盘/端盖/O 型圈/螺钉位置正确；**3 个柱塞的径向位置错误**（原因见 §4） |
| 干涉检查 | ⚠️ **分析完成，CAD 实检受限** | 解析间隙表全部通过；CAD 实检因柱塞错位无法作为有效判据 |
| 运动仿真 | ⚠️ **理论完成，SW 动态未完成** | 24 个转角的三柱塞位移/弹簧长度/配流状态全表已交付；SW Motion Study 无法驱动柱塞 |
| 工程图 | ⚠️ **1 / 4** | 配流盘图已完成（DWG+DXF+PDF）；装配图、泵体图、偏心轴图未完成 |
| 图层规范 / 技术要求 / 明细栏 | ✅ 已定义 | 规范写进 `DESIGN_SPEC.md` §9 与 §4/§5 |

**未完成的根因不是"没做"，是我用的 SolidWorks 桥接器（v0.2.1）有三项功能实测失效，见 §4。**

---

## 二、已完成的零件（全部实测回读，不是"看着像"）

| 件号 | 名称 | 体积 mm³ | 包围盒 mm | 关键实测 | sha256 前 8 位 |
|---|---|---|---|---|---|
| BP-01 | 泵体 | **376,159.161523** | Ø104×56 | 3×Ø12.5@0/120/240 至 R48；3×Ø5@R26；2×M14@90°/270°；6×M5 Ø4.2@Ø88 深16；1° 拔模；40 特征 0 错误 | `63d0b4d7` |
| BP-02 | 偏心轴 | **26,474.290684** | 25.7×24×93 | e₁ 实测 +2.500（Ø24）；e₂ 实测 −1.200（Ø20）；两键槽 4×2.5；退刀槽 Ø13×2；37 特征 0 错误 | `04f4e2ee` |
| BP-03 | 柱塞 | **2,462.415505** | 12×12×29 | 球头 R5 + Ø12×18 + 环槽(Ø8.6×2.4) + Ø8×6 导杆 | `ced2dc05` |
| BP-04 | 回程盘 | **47,385.076726** | 104×104×10.089 | 球冠 R40（r10 处凸 4.0888）；3×沉头 Ø5.5/Ø10@Ø88；密封槽 **Ø70**（实测槽底环面 835.664 = π(36.9²−33.1²)） | `ba4bea99` |
| BP-05 | 配流盘 | **19,618.731866** | 64×64×10 | 腰型窗实测 内弧 Ø45.000068 / 外弧 Ø58.999923、径向边 α=10/170/190/350°、包角 160°×2、岛 20°×2 | `4f27cb2d` |
| BP-06 | 端盖 | **93,469.858619** | 104×104×12 | Ø16H7；6×Ø5.5@Ø88；密封槽 **Ø70**（内壁 Ø66.2/外壁 Ø73.8/深 2.4）；凹球座 R40 实测深 4.0888 | `eacee309` |
| BP-07 | 弹簧 | **284.244607**（自由态）/ **284.244607**（安装态） | 11.2×11.2×**17**（自由）/ **13**（安装） | ⚠️ **8 圈环形叠片，非真螺旋体**，见 §5 D-01 | `84ebdc55` |
| 标准件 | 螺钉 / O 型圈 | M5×20: 631.60；M4×10: 261.42；O 型圈 67×3: **1,554.462693**；O 型圈 10×1.8: 94.33 | — | 全部参数化等效件 | — |

**液力参数**：3 柱塞、柱塞 Ø12、偏心 e₁=2.5 → 行程 **5.000**、排量 **1.696 mL/r**（取整 1.70）、n=1450 → 理论 **2.460 L/min**、10 MPa、轴功率 **0.482 kW**（配 0.55 kW）。
**流量脉动系数 δq ≈ 7.18%**（三柱塞正弦叠加）。

---

## 三、设计过程中查出并修掉的真实缺陷（这部分是本次交付最硬的价值）

设计书从 v1.0 一路改到 v1.3，**每一次改都是因为发现了一个会让人返工或让零件报废的错误**：

| # | 缺陷 | 后果（若不改） | 谁发现 | 修法 |
|---|---|---|---|---|
| 1 | 中心腔 Ø30 装不下 Ø40 回程盘 | 装配装不进去 | Lead | 腔改 Ø44，柱塞孔起点 R15→R22 |
| 2 | 配流孔 R19 落在 Ø44 腔壁内 | 配流孔与柱塞孔不连通，泵不打油 | Lead | 配流孔改 R26，配流盘 Ø56→Ø64 |
| 3 | **配流窗口 110°/70° 布局** | 120°、240° 柱塞**在行程中途换向 → 憋压**，泵会响会振 | Lead（相位校验） | 改 **160°/20°，岛跨 ±X 轴**，三柱塞换向严格落在死点 |
| 4 | 端盖 Ø88 密封槽与 Ø92 螺栓孔径向重叠 2.55 mm | 六处破口，密封全废 | sub-cad | 槽改小 + 螺栓孔统一到 Ø88 |
| 5 | 弹簧 Ø1.6/8 圈/自由长 17 | **压并长 16.96 > 最小工作长 10.5 → 行程走一半就压死** | Lead（刚度校核） | 线径改 Ø1.2、有效圈 6，压并 9.6 ✔ |
| 6 | **轴装式回程盘几何无解** | 中心孔 ≥Ø30 才能越过偏心轮包络 Ø29，但沉头孔只能在 R9 才能拧进 Ø24 偏心轮 → 两头夹死 | sub-rotor + sub-plunger 独立发现，Lead 穷举确认 | 回程盘改**壳体上端封压盘**，端盖上移 z62→74，总高 68→74 |
| 7 | 偏心轮端面 M4 分度圆 Ø18 破出外圆 0.126 mm | 螺纹破口 | sub-rotor | 该 3 孔整体取消 |
| 8 | **M5 底孔与油口同方位 60°/300° 贯通** | 压力油窜进螺钉孔，外漏 | sub-housing | 油口改 **90°/270°**；实测泵体 −139.15 mm³，质心回正到 (1.5e-5, 5e-6) 双轴对称 |
| 9 | **回程盘 Ø78 密封槽与自身 Ø10 沉头孔重叠 1.9 mm**（z 向） | 密封带被打穿 = 泄漏通道 | sub-housing 提线索，sub-plunger 定量 | 槽改 **Ø70**，O 型圈 75×3→**67×3**；泄漏当量 3×9.924 mm²×1.9 = **56.57 mm³** 五级印证闭合到 0.00 |
| 10 | R3 圆角（腔壁与柱塞孔相交处） | 几何上无收口位置（孔起点 R22 = 腔半径，两面相切） | sub-housing | 不做，写明理由，不改 R24（会连带改导向长度与配流孔位） |

---

## 四、未完成项与根因（桥接器能力边界，实测结论）

SolidWorks 桥接器 v0.2.1，以下三项**经受控实验证实失效**：

1. **`sw_assemble` 的 `rotate` 参数完全无效**
   实测：柱塞件以 `rotate:[90,0,0]` 与 `[0,90,0]` 分别插入，探针 `[300,0,15]` 均命中 Ø8 圆柱面（box z 18.5~23.5）——**零旋转**，件仍是轴向。
   ⇒ 无法把柱塞/弹簧/O 型圈摆到 120°、240° 径向。

2. **`concentric` 配合只能部分定向**
   用圆形边做同心配合，能把柱塞轴线转到径向（三个柱塞方位 0/120/240 均正确），但**方向符号与轴向滑动位置由求解器随机决定**：实测柱塞-1 被翻成球头朝外，且滑到孔底（球心半径 51.5，应在 19.5）。补 `distance` 配合因两面已重合，取点解析到同一零件而失败。

3. **无 `move`/`transform` 组件操作**，一旦放错无法修正，只能重建装配体。

**结论**：这台泵是**三柱塞 120° 径向**结构，而桥接器只能可靠放置轴向零件 ⇒ **完整的三维装配 + Motion Study 柱塞往复，在本工具链下不可达成**。这不是"没试"，是三条路都试到底并留下了实测证据。

### 补救路径（你手工 3 步可完成，或换带 API 的 SW 环境）
1. 打开 `pump\PUMP_ASSY.sldasm`，把 3 个 `BP03_plunger` 删除；
2. 手工插入 3 次柱塞，各自加「同心 + 距离 13/14.25/14.25」配合（方向朝内，球头贴偏心轮）；
3. 插入 3 个 `BP07_spring_inst`（安装长 13）与 3 个 `STD_oring_10x18`，同法定向；然后 Motion Study 加旋转马达 = 完成客户要的运动仿真。

---

## 五、偏差登记（详见 `DEVIATIONS.md`）

- **D-01 弹簧非真螺旋**：`cad_sweep` 直管精确（22.62 = π·0.36·20）但 1 圈螺旋只得 0.16 mm³、8 圈 1.30 mm³ → 该内核扫掠不接受离开起始平面的路径；`cad_loft` 33/65 截面两次均报 `sections too dissimilar`；FreeCAD 未安装；MCP 侧 sweep 工具 schema 无文档且曾卡死 SW。⇒ 交付 8 圈环形叠片（体积 284.24 与「8×单环 35.53」精确吻合）。**你本地手工扫掠一次即可替换，参数在 `DESIGN_SPEC.md §3.7`。**
- **D-02 模型未赋材料**：桥接器无赋材料接口，`mass_kg` 无工程意义，材料在明细栏标注。
- **D-03 未注 R0.8 未逐边实现**：避免吃掉键槽 4 mm 宽与孔口，按图纸技术要求由工艺保证。
- **D-05 回程盘功能重定位**：轴装方案几何无解（§3 第 6 条），改为壳体上端封压盘；回程力由 3 个柱塞弹簧独立提供。
- **D-06 客户技术要求第 1 条**：「配流盘与柱塞球面配合面研磨」**原文照抄进图纸**，但本设计为端面配流，两者无直接配合面——**若客户本意是别的结构型式，此条需回退重议**。

---

## 六、文件清单

```
deliver/
├── sw/          18 个 SLDPRT + 1 个 SLDASM（含中间版本 _v2，最终件见 §2 表）
├── cad/         BP05_配流盘.dwg / .dxf / .pdf（其余 3 张未完成）
└── doc/
    ├── DESIGN_SPEC.md        设计书 v1.3（含 v1.0→v1.3 全部修正记录）
    ├── DEVIATIONS.md         偏差与简化登记
    ├── KINEMATICS.md         柱塞运动学表（24 转角 × 三柱塞，含配流状态）
    ├── portplate_geometry.md 配流盘腰型窗逐点坐标 + 相位表
    └── RESULT.md             泵体/端盖建模验收记录（sub-housing）
```

---

## 七、我需要你拍板的三件事

1. **结构型式**：我按「径向柱塞 + 随轴旋转端面配流盘」定案。若你原意是轴向柱塞（斜盘式）或双作用，**整套设计要重做**——现在改比重做完再改便宜。
2. **回程盘重构**是否接受（轴装无解，改壳体装压盘）。
3. **弹簧**是否接受环形叠片近似（或你在本地 SW 手工扫掠一次）。

我可能错在哪：第 3 条的「径向是唯一自洽解」是我基于「偏心只能驱动径向柱塞」推的，但如果你手上已有现成的偏心柱塞泵图纸作为依据，以图纸为准，我按图纸重做。
