GBK-com/Delumenyu/小型偏心柱塞泵/HANDOFF.md

# 续做交接单（2026-11-01 收工 / 2026-11-02 补更两次）

---

## ★★ 2026-11-02 中午：总装做成并已存盘（最重要的里程碑）

**`pump\PUMP_ASSY.sldasm` · 312,627 B · sha256 `5379e202bac9fc571af7abc17f65baf894edaa1843093688a5f47b82243e27a2`**
16 个组件：泵体(固定) + 偏心轴(固定) + 3×柱塞 + 配流盘 + 回程盘 + 端盖 + 2×O型圈67×3 + 3×M5×30 + 3×M5×20。

### 三根柱塞位置：与 θ=0 运动学表逐位吻合
| 柱塞 | 装配坐标 | 实测 ρ | 方位 | 运动学期望 |
|---|---|---|---|---|
| 0° | (19.500, 0, 22) | 19.500 | 0° | 19.500 ✔ |
| 120° | (−7.875, 13.640, 22) | 15.750 | 120° | 15.750 ✔ |
| 240° | (−7.875, −13.640, 22) | 15.750 | 240° | 15.750 ✔ |

### 装配配方（**推翻昨晚"无解"结论的关键**，务必按序）
1. **先 `fix` 偏心轴**——否则相切配合会把**轴**拖走（实测被拖到 x=162.7）
2. 柱塞件用 **`BP03_plunger_b`**（球头在 +Z 端、机体向 −Z，体积 2467.117）——原版 `BP03_plunger` 会被同心配合翻成球头朝外
3. `concentric`：柱塞**肩部圆边** ↔ 泵体柱塞孔**盲端圆边** → 只定轴线，方向与滑动位置仍随机
4. `distance`：柱塞**肩部圆面**（取点要在 r 4~6 的圆环上，**不能取轴心**，否则取不到面）↔ 泵体**孔底面**，距离按行程给
   - θ=0 时：0° 柱塞 **10.5**，120°/240° 柱塞 **14.25**（= 48 − (ρ+18)）
   - 一条 distance 同时解决"在哪一侧"和"行程"两个自由度
5. 柱塞初始插入位置要放在**各自孔的正确一侧**（如 0°/120°/240° 方向半径 60 处），否则同心会把它甩到反侧

### 干涉检查结果：10 项，其中真缺陷 1 项
| 项 | 体积 | 判定 |
|---|---|---|
| 3×M5×30 vs 泵体 | 279.53 | 螺纹名义干涉（光杆 Ø5 进 Ø4.2 底孔），等效件固有，可接受 |
| 3×M5×20 vs 泵体 | 221.40 | 同上 |
| O型圈67×3 ×2 vs 沟槽 | 221.32 | 设计压缩 0.6 mm，正常 |
| **偏心轴 vs 配流盘** | **86.805** | **真缺陷，待修（见下）** |
| 回程盘 vs 端盖 | 0.005 | 球面接触，可忽略 |

**⚠ 唯一的真缺陷**：偏心轴 Ø20 段从 z=−1 起，而配流盘中心孔 Ø16.5 且占到 z=0，所以 z −1→0 有 1 mm 轴伸进孔里。
**修法（已派给 sub-rotor，SW 一恢复就能做）**：配流盘**上端面（局部 z=10）加 Ø21 沉孔、深 1**。预期体积 ≈19,486 ml（sub-rotor 提醒：因键槽与孔口倒角已占去约 16 mm³，实际会比 19,486.2 略高几 mm³，以实测为准）。

### 运动仿真状态
- MCP 侧**只有旋转马达、没有直线马达** → 柱塞要动必须靠**相切**耦合
- 相切与 distance 配合**互斥**（都是约束同一自由度），所以运动要在**另一个装配体**里做
- 已实测：柱塞初始放在正确一侧（半径 60 / 方位 0-120-240）后，三个 concentric 全部落在**正确一侧**（半径 42）✔ —— 这条是真突破，说明运动装配体可行
- 因 SW 崩溃，运动装配体（装配体4）未存盘，需重建

### 恢复工作后的顺序
1. 启动 SOLIDWORKS（bridge 不能自己起）
2. 让 sub-rotor 改配流盘（Ø21×1 沉孔）
3. 重开 PUMP_ASSY，替换配流盘为改后件 → 干涉复检 → 期望只剩「螺纹名义干涉 + O 型圈压缩」两类，**0 项真缺陷**
4. 建运动装配体：housing + shaft(fix) + 3×plunger_b(半径60处) → concentric → tangent → 加旋转马达 → 出运动结果
5. 出最后一张装配图 A1（sub-cad）

---

## ★ 2026-11-02 上午进展（按客户要求停工时的状态）

**图纸从 2/4 推进到 3/4：BP-02 偏心轴零件图已出**（`cad/BP02_偏心轴.dwg/.dxf/.pdf`，09:43 导出，29157/156902/123082 B）。
**唯一还缺：BP-00 装配图 A1。**

### 关键突破：柱塞径向定位的办法找到了（推翻昨天的"无解"结论）

| 步骤 | 做法 | 实测结果 |
|---|---|---|
| 1 | 重测 `rotate` | **确认彻底失效**——全新空装配体、`[0,90,0]`，柱塞杆仍在 z 18.5~23.5 → 不再浪费调用 |
| 2 | `concentric` + 圆形边定向 | **轴线方向能转对**（三柱塞方位 0/120/240 均正确），但**方向符号固定翻转**：球头被翻成朝外、且滑到孔底 |
| 3 | **换朝向重建模柱塞** | 球头建在 **+Z** 端、机体向 **−Z** 延伸（原版球头在 −Z）。文件 `pump\BP03_plunger_b.sldprt`，体积 **2467.117**（理论 2467.2 ✔），box 12×12×29 ✔，sha `2885eeb2f4f376e2…` |
| 4 | 用新件做同心配合 | **方向正确**：球头在 x 177~182（朝内），机体向 +X 到 206 |

**可复现的规律**：`concentric` 会让件产生一个固定方向的翻转；把零件按「翻转后正好正确」的朝向建模即可，不是撞运气。

### 恢复工作后从这里接（约 4 步，半天内能完）

1. 插入 **BP03_plunger_b**（×3，**不是** BP03_plunger）+ **BP02_ecc_shaft**
2. 每个柱塞 `concentric`：柱塞肩部圆边 ↔ 泵体柱塞孔盲端圆边 → 方向自动正确
3. 每个柱塞 `tangent`：球面 ↔ 偏心轮圆柱面 → **位置由偏心轮自己决定**，同时建立运动耦合（Motion Study 才能真正让柱塞往复）
   - ⚠️ 昨天踩过的坑：相切目标点 `[14.5,0,22]` 属**偏心轴**，轴没插入时会误配到泵体孔上。**先插轴，再加相切**
4. 干涉检查 → Motion Study 加旋转马达

### 三柱塞配合取点（装配坐标，θ=0）

| 柱塞 | 泵体孔盲端圆边 | 偏心轮表面 |
|---|---|---|
| 0° | `[48, 6.25, 22]` | `[14.5, 0, 22]` |
| 120° | `[-29.41, 38.44, 22]` | 待算（偏心轮方位 120° 处：`[2.5cos120+12cos120, 2.5sin120+12sin120, 22]`） |
| 240° | `[-18.59, -44.69, 22]` | 待算（同上，换 240°） |

另：柱塞插入时先放远处（如 `[200,0,0]`），配合会把它拉到位；放在泵体里会因初始干涉导致配合被拒。

---

# 原始交接单（2026-11-01 23:20 收工）

> **一句话状态**：8 类零件全部建模完成并逐件实测验收；工程图 4 张完成 2 张（配流盘、泵体）；
> **卡点是三维装配里 3 个径向柱塞摆不正**（SolidWorks 桥接器 `rotate` 参数实测失效）；装配图、偏心轴图未做。

---

## 一、续做时先读这四个文件（按顺序）

| 文件 | 作用 |
|---|---|
| `DELIVERY.md` | 交付状态总表 + 10 条设计缺陷的修复记录（最重要的工程资产） |
| `doc/DESIGN_SPEC.md` | **设计书 v1.3**，唯一尺寸依据。顶部有 v1.0→v1.3 的全部修正表 |
| `doc/DEVIATIONS.md` | 9 条偏差登记（弹簧、材料、R0.8 等） |
| `doc/KINEMATICS.md` | 柱塞运动学表（24 个转角 × 三柱塞位移/弹簧长度/配流状态） |

---

## 二、已完成件（sha256 前 16 位，均已落盘且 `dirty:false`）

| 文件 | sha256 | 体积 mm³ |
|---|---|---|
| `BP01_housing.sldprt`（泵体，v1.3 油口 90°/270°） | `63d0b4d7e82e2d92` | 376,159.161523 |
| `BP02_ecc_shaft.sldprt`（偏心轴） | `04f4e2ee92059c4a` | 26,474.290684 |
| `BP03_plunger.sldprt`（柱塞） | `ced2dc057a3f3ab5` | 2,462.415505 |
| `BP04_retainer_v2.sldprt`（回程盘，槽 Ø70，**以此为准**） | `ba4bea99f9262909` | 47,385.076726 |
| `BP05_portplate.sldprt`（配流盘） | `4f27cb2dfd1ff914` | 19,618.731866 |
| `BP06_endcover.sldprt`（端盖，槽 Ø70） | `eacee309a32b9b47` | 93,469.858619 |
| `BP07_spring.sldprt`（弹簧，自由长 17，8 圈叠片） | `84ebdc55cac4f5b0` | 284.244607 |
| `BP07_spring_inst.sldprt`（安装态，长 13） | — | 284.244607 |
| `STD_oring_67x3.sldprt` / `STD_oring_10x18` / `STD_screw_M5x20` / `STD_screw_M4x10` | — | 1,554.46 / 94.33 / 631.60 / 261.42 |
| `PUMP_ASSY.sldasm`（装配体，**柱塞位置待修**） | `c868d0714a84e202` | — |

⚠️ 作废件：`BP01_housing_v2`、`BP06_endcover_v2`、`BP04_retainer`（旧 Ø78 槽版）、`STD_oring_75x3`、`STD_screw_M4x10`、`_tmp_*`。**别用。**

---

## 三、图纸状态

| 图 | 状态 | 文件 |
|---|---|---|
| BP-05 配流盘零件图 A3 | ✅ 完成（finalize 92 分/B，腰型窗 160°/20° 真实 ARC + 剖视 + 6 处形位公差） | `cad/BP05_配流盘.dwg/.dxf/.pdf` |
| BP-01 泵体零件图 A3 | ✅ 完成（主视图+俯视图+B-B 全剖+7 处剖面线+11 个真实尺寸+6 形位公差+3 处 Ra） | `cad/BP01_泵体.dwg/.dxf/.pdf` |
| **BP-00 装配图 A1** | ❌ **未做** | — |
| **BP-02 偏心轴零件图 A3** | ❌ **未做** | — |

---

## 四、明天第一件事：修装配体的柱塞位置

### 卡点（已受控实验证实，别再试）
- `sw_assemble` 的 **`rotate` 参数完全失效**：`[90,0,0]` 与 `[0,90,0]` 两种都给零旋转（探针实测杆件仍在 z 18.5~23.5）。
- `concentric` 用圆形边可以定向（三柱塞方位已对），但**方向符号随机（会翻成球头朝外）、轴向位置随机（滑到孔底）**。
- 补 `distance` 配合失败：两面已重合，取点解析到同一零件。
- 无 `move`/`transform` 组件操作，放错只能重建。

### 三条可行路线（按推荐排序）
1. **手工修（最快，5 分钟）**：打开 `PUMP_ASSY.sldasm` → 删掉 3 个 `BP03_plunger` → 手工插入 3 次，各加「同心 + 距离」配合，方向朝内、球头贴偏心轮，距离取 **13 / 14.25 / 14.25**（对应 θ=0 时 ρ=19.5 / 15.75 / 15.75）。再插 3 个 `BP07_spring_inst` 与 3 个 `STD_oring_10x18`。然后 Motion Study 加旋转马达 → 柱塞往复即可演示。
2. **纯手算交付**：不要 SW 装配，直接用 `doc/KINEMATICS.md` 的 24 行表 + 8 张转角截图作为运动仿真证据。
3. **换环境**：用有 SW API（VBA/Python）的环境写循环改 `Component2.Transform2`，可全自动。

### 修好后要做的
- `sw_interference`（预期残留项只有三类，都能解释）：螺钉螺纹等效件与底孔的**名义**干涉、O 型圈压缩干涉、弹簧与孔底接触。
- `sw_bom` 核对明细栏 11 项。
- `sw_export` 出 STEP。

---

## 五、明天第二件事：补两张图

- **BP-02 偏心轴零件图 A3**：9 段阶梯（Ø16/13/20/24/20/20/20/16）+ 总长 93 + 两处键槽 4×2.5（z −12~−4、70~78）+ 退刀槽 Ø13×2 + 偏心轮端视图标 e₁=2.5±0.02。形位公差见 `DESIGN_SPEC.md §6`。
- **BP-00 装配图 A1**：主视图 + A-A 全剖 + 序号 11 项 + 明细栏 + 技术要求 5 条（原文照抄）+ 追加 2 条。可省柱塞方位剖视。

---

## 六、必须保留给客户的三件事（已在 DELIVERY.md §7）

1. 结构型式确认为「径向柱塞 + 随轴旋转端面配流盘」——若不是，整套要重做。
2. 回程盘重构（轴装无解 → 壳体上端封压盘）是否接受。
3. 弹簧为 8 圈环形叠片（非真螺旋）是否接受。

---

## 七、环境事实（明天别再踩）

- SW 桥接器**只能写** `C:\Users\谷博康\Documents\dsh-solidworks\`，工作区 `Desktop\sw` 写不进；`save_enabled=false`，覆盖源文件会被拒，需 `save-as _tmp → sw_export overwrite`。
- `sw_build` 只有 sketch/extrude/revolve/fillet/chamfer/shell/plane/delete：**无 sweep、无 pattern、无 move**。拔模用 extrude 的 `draft`。
- **revolve 的轴线只认水平/垂直**，120°/240° 的径向孔必须靠 `solidworks_pattern`（MCP 侧）圆周阵列。
- MCP 侧 `solidworks_build_round_sweeps` schema 无文档且曾令 SW 卡死 —— **别碰**。
- AutoCAD 2024 COM 在线，`mcp__autocad__` 247 个工具；`drawing_finalize` 是验收闸口，`drawing_critique` 必须在 finalize 前清空。
