GBK-com/Delumenyu/小型偏心柱塞泵/doc/portplate_geometry.md

# 配流盘 BP-05 腰型配流窗 — 最终几何（Lead 复算，v1.1 定稿）

单位 mm；原点 = 配流盘中心；+X = 0°，逆时针为正。
盘体 Ø64 × 10，中心孔 Ø16.5，键槽 4×2.5（+X 母线）。
腰型窗：内 R22.5，外 R29.5（径向宽 7，中径 R26）。
**包角各 160°，岛角各 20°，岛中心线在 α=0°(+X) 与 α=180°(−X)。**

## 相位依据（为什么岛必须跨 ±X 轴）
配流盘随轴转 θ，柱塞 i 在壳体方位 φᵢ，其见到的配流盘坐标 α = φᵢ − θ。
柱塞 i 的位移极值出现在 θ = φᵢ（外死点，α=0）与 θ = φᵢ+180°（内死点，α=180°）。
⇒ 三个柱塞的换向点**同时**落在 α=0 与 α=180，因此岛必须以 α=0/180 居中。
校验：φ=0/120/240 三条柱塞，两个死点均落在岛上，各留 10° 密封过渡。✔

## 窗 A（压油，+Y 半侧）α ∈ [10°, 170°]
- 内弧：起 `[22.1582, 3.9071]` → 中 `[0, 22.5]` → 止 `[-22.1582, 3.9071]`
- 外弧：起 `[29.0518, 5.1226]` → 中 `[0, 29.5]` → 止 `[-29.0518, 5.1226]`
- 径向边 1：`[22.1582, 3.9071]` → `[29.0518, 5.1226]`
- 径向边 2：`[-29.0518, 5.1226]` → `[-22.1582, 3.9071]`

内弧 10° 取样：
```
[[22.1582,3.9071],[21.1431,7.6955],[19.4856,11.25],[17.236,14.4627],[14.4627,17.236],[11.25,19.4856],[7.6955,21.1431],[3.9071,22.1582],[0,22.5],[-3.9071,22.1582],[-7.6955,21.1431],[-11.25,19.4856],[-14.4627,17.236],[-17.236,14.4627],[-19.4856,11.25],[-21.1431,7.6955],[-22.1582,3.9071]]
```
外弧 10° 取样：
```
[[29.0518,5.1226],[27.7209,10.0896],[25.5477,14.75],[22.5983,18.9622],[18.9622,22.5983],[14.75,25.5477],[10.0896,27.7209],[5.1226,29.0518],[0,29.5],[-5.1226,29.0518],[-10.0896,27.7209],[-14.75,25.5477],[-18.9622,22.5983],[-22.5983,18.9622],[-25.5477,14.75],[-27.7209,10.0896],[-29.0518,5.1226]]
```

## 窗 B（吸油，−Y 半侧）α ∈ [190°, 350°]
- 内弧：起 `[-22.1582, -3.9071]` → 中 `[0, -22.5]` → 止 `[22.1582, -3.9071]`
- 外弧：起 `[-29.0518, -5.1226]` → 中 `[0, -29.5]` → 止 `[29.0518, -5.1226]`
- 径向边 1：`[-22.1582, -3.9071]` → `[-29.0518, -5.1226]`
- 径向边 2：`[29.0518, -5.1226]` → `[22.1582, -3.9071]`

内弧 10° 取样：
```
[[-22.1582,-3.9071],[-21.1431,-7.6955],[-19.4856,-11.25],[-17.236,-14.4627],[-14.4627,-17.236],[-11.25,-19.4856],[-7.6955,-21.1431],[-3.9071,-22.1582],[0,-22.5],[3.9071,-22.1582],[7.6955,-21.1431],[11.25,-19.4856],[14.4627,-17.236],[17.236,-14.4627],[19.4856,-11.25],[21.1431,-7.6955],[22.1582,-3.9071]]
```
外弧 10° 取样：
```
[[-29.0518,-5.1226],[-27.7209,-10.0896],[-25.5477,-14.75],[-22.5983,-18.9622],[-18.9622,-22.5983],[-14.75,-25.5477],[-10.0896,-27.7209],[-5.1226,-29.0518],[0,-29.5],[5.1226,-29.0518],[10.0896,-27.7209],[14.75,-25.5477],[18.9622,-22.5983],[22.5983,-18.9622],[25.5477,-14.75],[27.7209,-10.0896],[29.0518,-5.1226]]
```

## 配流相位表（装配图配流原理图用）

| 柱塞方位 φ | 外死点 θ | 内死点 θ | 压油窗口 θ 区间 | 吸油窗口 θ 区间 |
|---|---|---|---|---|
| 0° | 0° | 180° | 10°–170° | 190°–350° |
| 120° | 120° | 300° | 130°–290° | 310°–110° |
| 240° | 240° | 60° | 250°–410°(=50°) | 70°–230° |

## 排量复核
d=12，s=2e=5，A=113.097 mm²；单柱塞 565.49 mm³；三柱塞 **1696.46 mm³ = 1.696 mL/r**（对外取整 1.70 mL/r）
n=1450 r/min → 理论流量 **2.460 L/min**；10 MPa、η=0.85 → 轴功率 **0.482 kW**（配 0.55 kW）

## 关键配合间隙表
| 配合 | 间隙/配合 mm | 说明 |
|---|---|---|
| 柱塞 Ø12 / 柱塞孔 Ø12.5 | 0.50 | H8/f7 间隙配合 |
| 柱塞导杆 Ø8 / 弹簧内径 Ø8.4 | 0.40 | 弹簧自由套入 |
| 弹簧外径 Ø11.6 / 孔 Ø12.5 | 0.90 | 无刮擦 |
| 轴 Ø16 / 配流盘孔 Ø16.5 | 0.50 | H8/f7 滑动 |
| 轴 Ø20 h6 / 泵体 Ø20 H7 | 0.020~0.041 | 间隙配合 |
| 回程盘 Ø40 / 中心腔 Ø44 | 2.00 | 径向自由 |
| 偏心轮包络 Ø29 / 中心腔 Ø44 | 7.50 | 安全 |
