GBK-com/Delumenyu/小型偏心柱塞泵/sw/PUMP_ASSY.sldasm

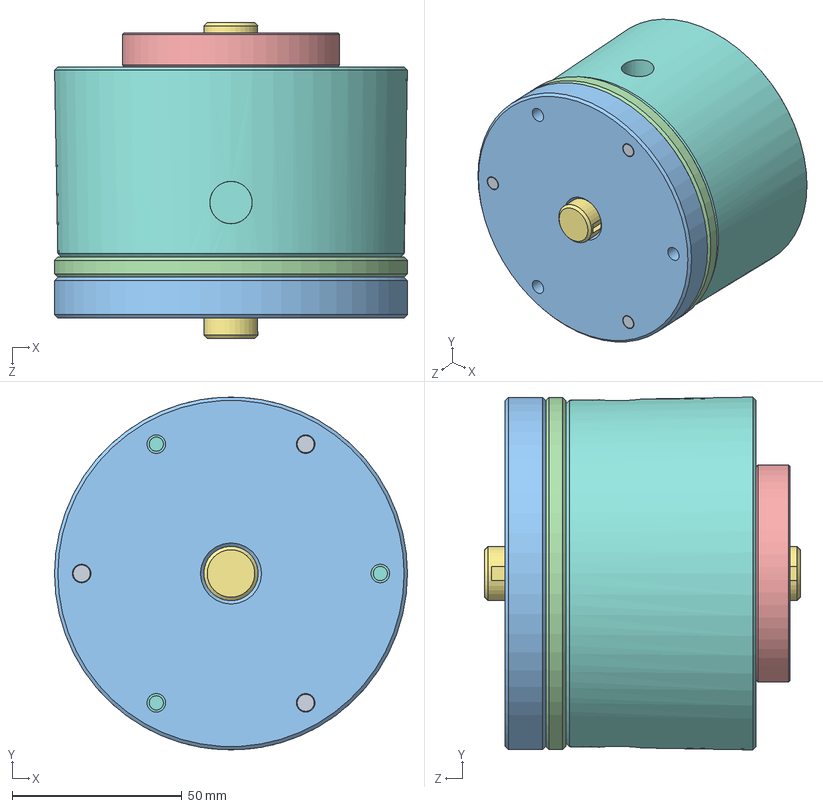
[picture p1: CAD file, 2026-11-02]
小型偏心柱塞泵/sw/PUMP_ASSY.sldasm
104.0 x 104.0 x 93.0 mm
BP01_housing
BP02_ecc_shaft
BP03_plunger_b x 3
BP05_portplate
BP04_retainer
BP06_endcover
STD_oring_67x3 x 2
STD_screw_M5x20 x 3
