GBK-com/Delumenyu/小型偏心柱塞泵/sw/PUMP_MOTION_study.sldasm

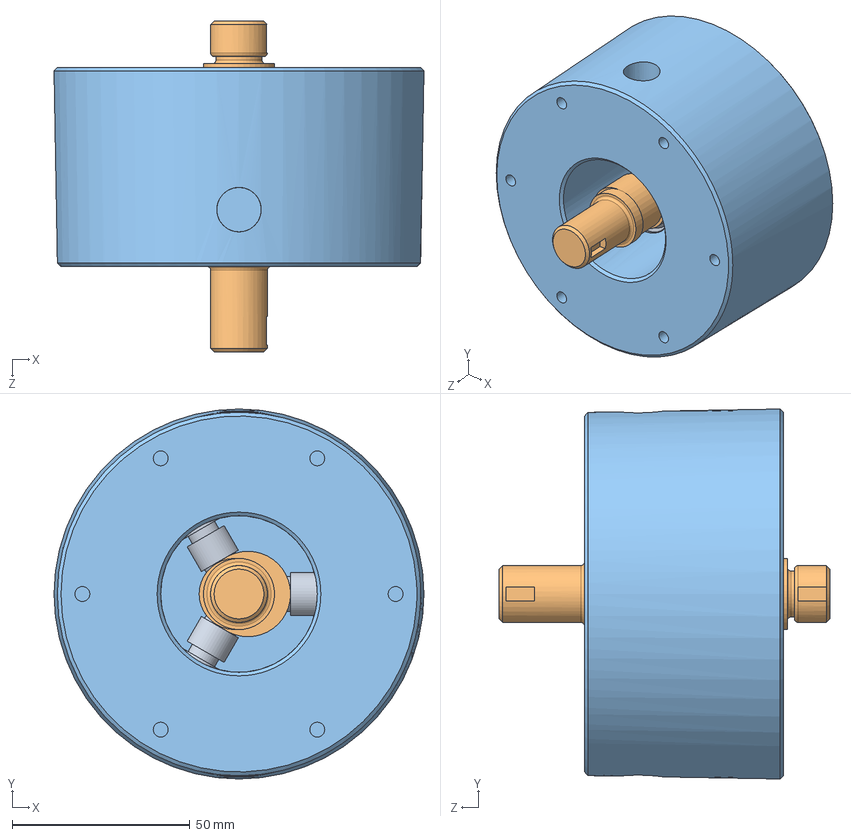
[picture p2: CAD file, 2026-11-02]
小型偏心柱塞泵/sw/PUMP_MOTION_study.sldasm
104.0 x 104.0 x 93.0 mm
BP01_housing
BP02_ecc_shaft
BP03_plunger_b x 3
