GBK-com/Delumenyu/小型偏心柱塞泵/cad/BP05_配流盘.dxf

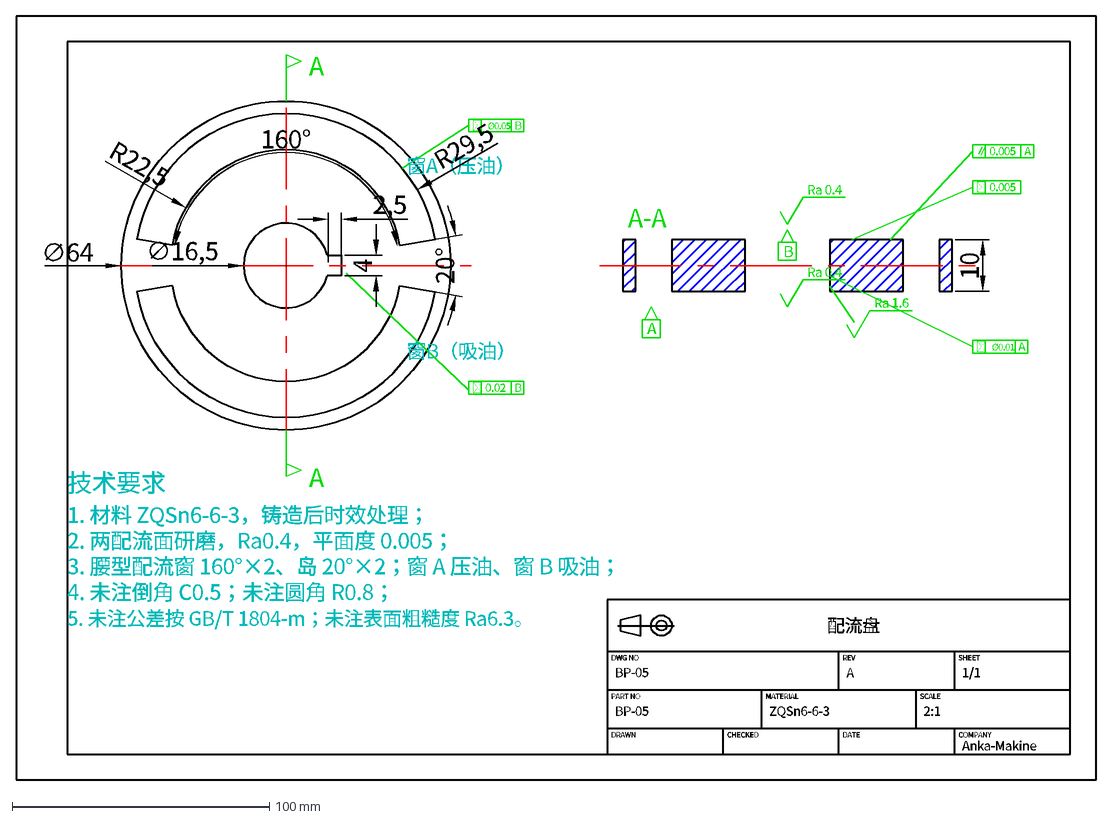
[picture p3: CAD file, 2026-11-02]
小型偏心柱塞泵/cad/BP05_配流盘.dxf
DWG NO
BP-05
REV
A
SHEET
1/1
PART NO
MATERIAL
ZQSn6-6-3
SCALE
2:1
DRAWN
CHECKED
DATE
COMPANY
Anka-Makine
∅64
R22,5
160°
20°
2,5
∅16,5
∥
0.005
B
0.02
A-A
Ø0.01
Ø0.05
Ra 0.4
Ra 1.6
配流盘
技术要求
1. 材料 ZQSn6-6-3，铸造后时效处理；
2. 两配流面研磨，Ra0.4，平面度 0.005；
3. 腰型配流窗 160°×2、岛 20°×2；窗 A 压油、窗 B 吸油；
4. 未注倒角 C0.5；未注圆角 R0.8；
窗A（压油）
窗B（吸油）
5. 未注公差按 GB/T 1804-m；未注表面粗糙度 Ra6.3。
R29,5
10
4
