GBK-com/Delumenyu/小型偏心柱塞泵/sw/BP03_plunger_b.SLDPRT

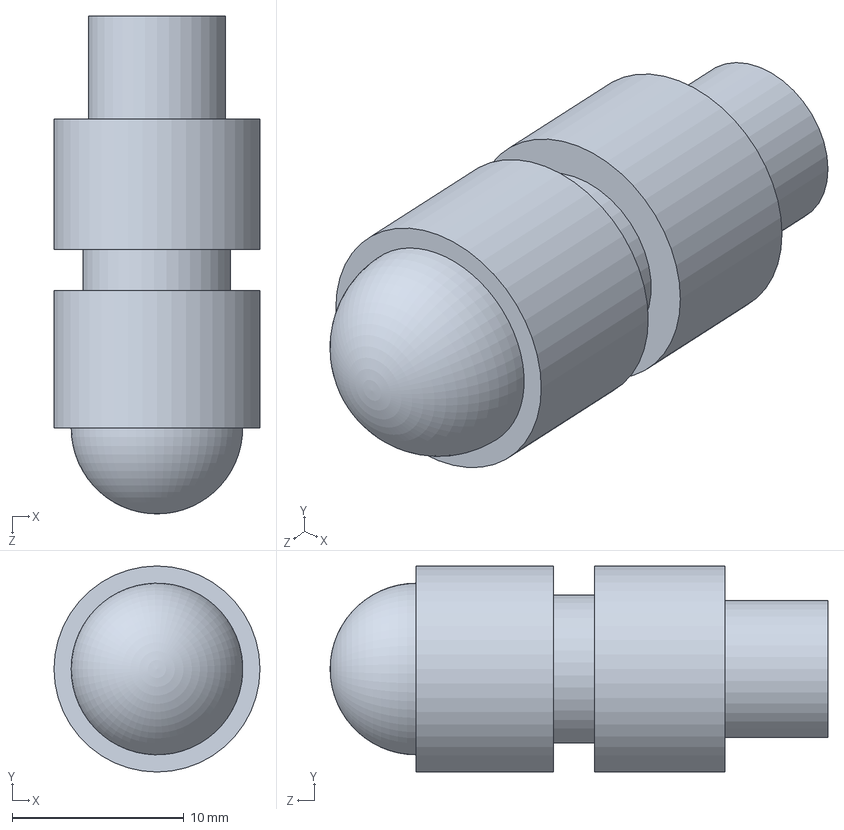
[picture p4: CAD file, 2026-11-02]
小型偏心柱塞泵/sw/BP03_plunger_b.SLDPRT
12.0 x 12.0 x 29.0 mm
