GBK-com/Delumenyu/小型偏心柱塞泵/sw/STD_oring_67x3.SLDPRT

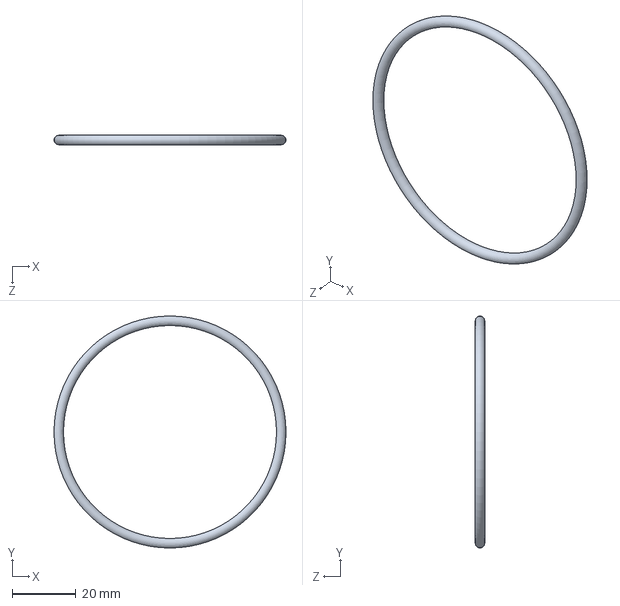
[picture p5: CAD file, 2026-11-02]
小型偏心柱塞泵/sw/STD_oring_67x3.SLDPRT
73.0 x 73.0 x 3.00 mm
