GBK-com/Delumenyu/小型偏心柱塞泵/cad/BP01_泵体.dxf

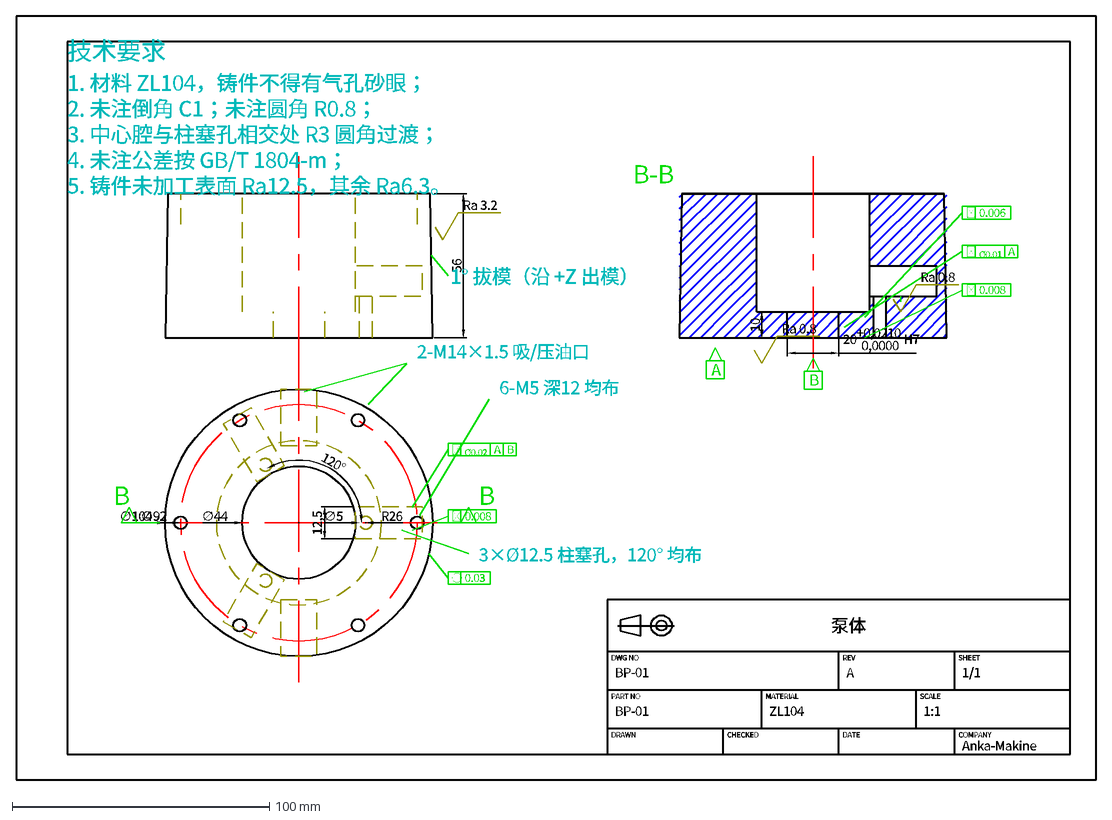
[picture p6: CAD file, 2026-11-02]
小型偏心柱塞泵/cad/BP01_泵体.dxf
泵体
DWG NO
BP-01
REV
A
SHEET
1/1
PART NO
MATERIAL
ZL104
SCALE
1:1
DRAWN
CHECKED
DATE
COMPANY
Anka-Makine
20+0,0210^ 0,0000 H7
∅104
∅44
56
12,5
∅5
R26
∅92
120°
10
0.006
0.008
B
○
0.03
Ø0.01
Ø0.02
B-B
技术要求
1. 材料 ZL104，铸件不得有气孔砂眼；
2. 未注倒角 C1；未注圆角 R0.8；
3. 中心腔与柱塞孔相交处 R3 圆角过渡；
4. 未注公差按 GB/T 1804-m；
5. 铸件未加工表面 Ra12.5，其余 Ra6.3。
3×Ø12.5 柱塞孔，120° 均布
6-M5 深12 均布
2-M14×1.5 吸/压油口
Ra 0.8
Ra 3.2
1° 拔模（沿 +Z 出模）
