GBK-com/Delumenyu/小型偏心柱塞泵/sw/BP06_endcover.SLDPRT

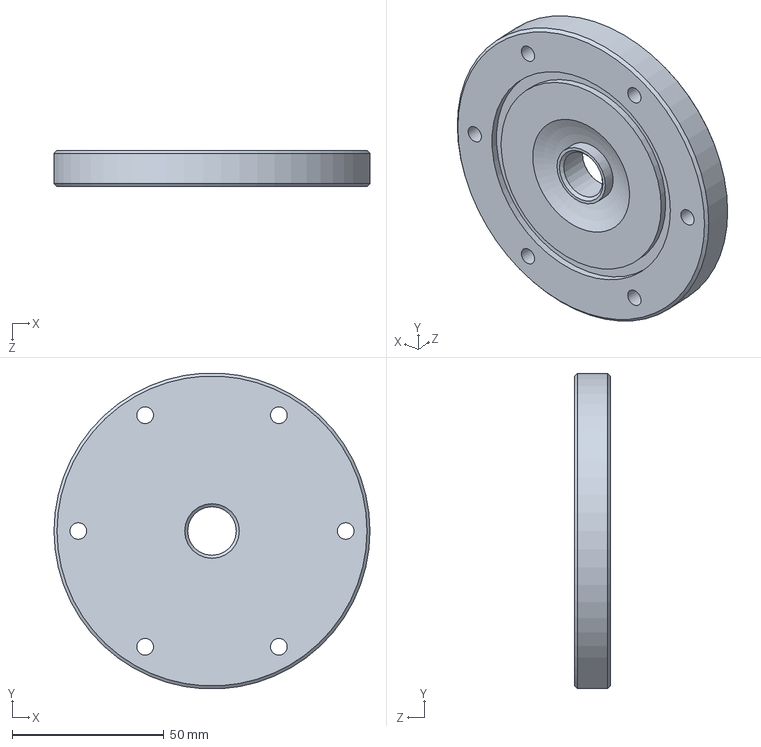
[picture p7: CAD file, 2026-11-02]
小型偏心柱塞泵/sw/BP06_endcover.SLDPRT
104.0 x 103.8 x 12.0 mm
