GBK-com/Delumenyu/小型偏心柱塞泵/cad/BP02_偏心轴.dxf

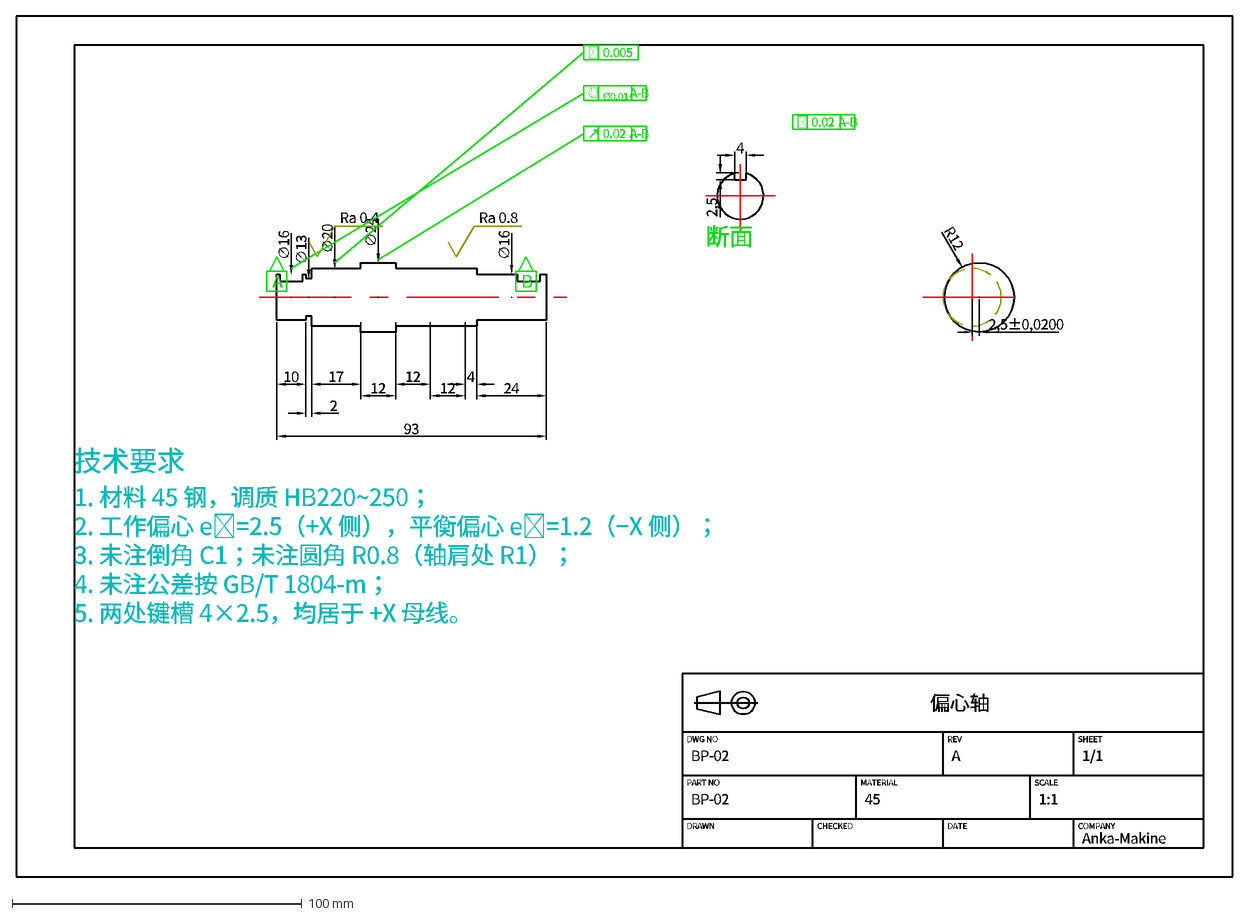
[picture p8: CAD file, 2026-11-02]
小型偏心柱塞泵/cad/BP02_偏心轴.dxf
偏心轴
DWG NO
BP-02
REV
A
SHEET
1/1
PART NO
MATERIAL
45
SCALE
1:1
DRAWN
CHECKED
DATE
COMPANY
Anka-Makine
断面
∅16
10
17
12
4
24
93
∅13
∅20
∅24
2,5
R12
2,5±0,0200
0.005
◎
A-B
↗
0.02
B
Ra 0.4
Ra 0.8
Ø0.01
技术要求
1. 材料 45 钢，调质 HB220~250；
3. 未注倒角 C1；未注圆角 R0.8（轴肩处 R1）；
4. 未注公差按 GB/T 1804-m；
5. 两处键槽 4×2.5，均居于 +X 母线。
2
