GBK-com/Delumenyu/小型偏心柱塞泵/sw/BP04_retainer.SLDPRT

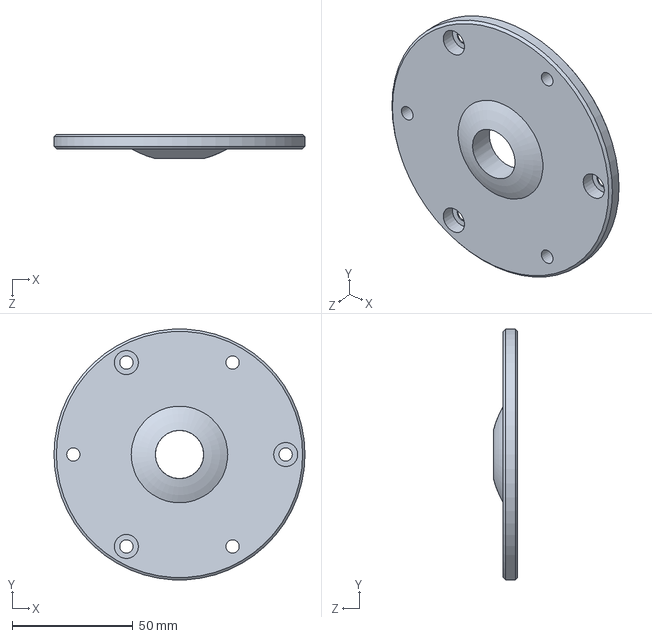
[picture p9: CAD file, 2026-11-02]
小型偏心柱塞泵/sw/BP04_retainer.SLDPRT
104.0 x 103.8 x 10.1 mm
