GBK-com/Delumenyu/小型偏心柱塞泵/sw/BP07_spring.SLDPRT

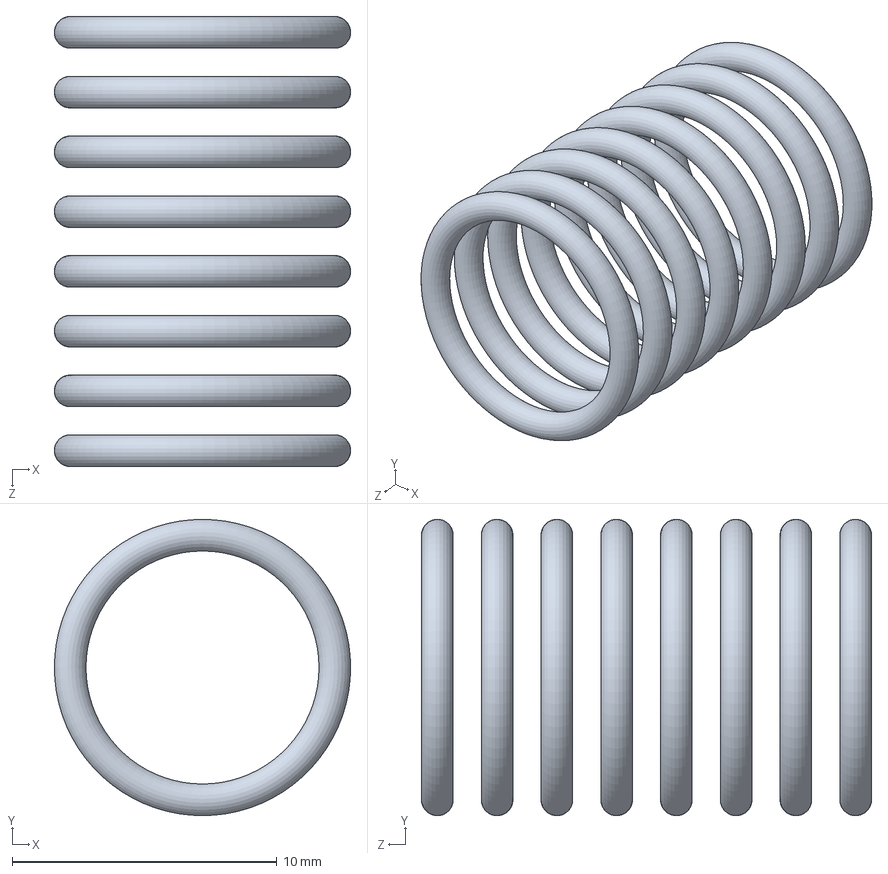
[picture p10: CAD file, 2026-11-02]
小型偏心柱塞泵/sw/BP07_spring.SLDPRT
11.2 x 11.2 x 17.0 mm
