GBK-com/Delumenyu/小型偏心柱塞泵/sw/BP01_housing.SLDPRT

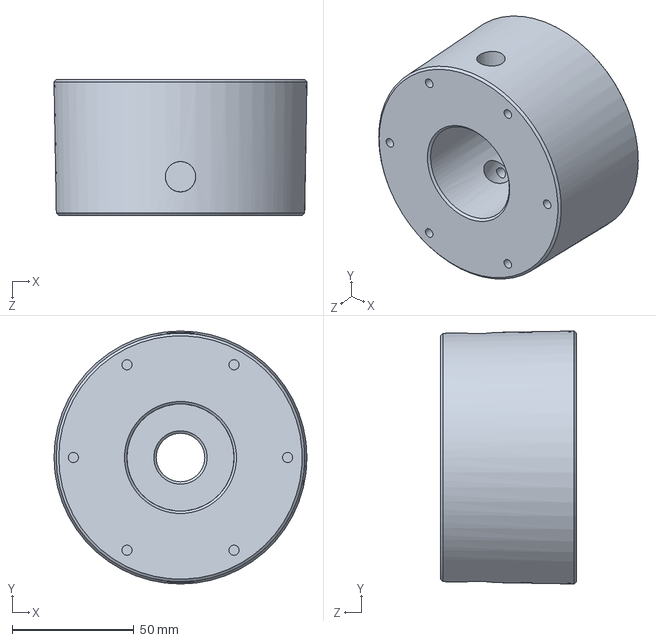
[picture p11: CAD file, 2026-11-02]
小型偏心柱塞泵/sw/BP01_housing.SLDPRT
104.0 x 104.0 x 56.0 mm
