GBK-com/Delumenyu/小型偏心柱塞泵/sw/BP07_spring_inst.SLDPRT

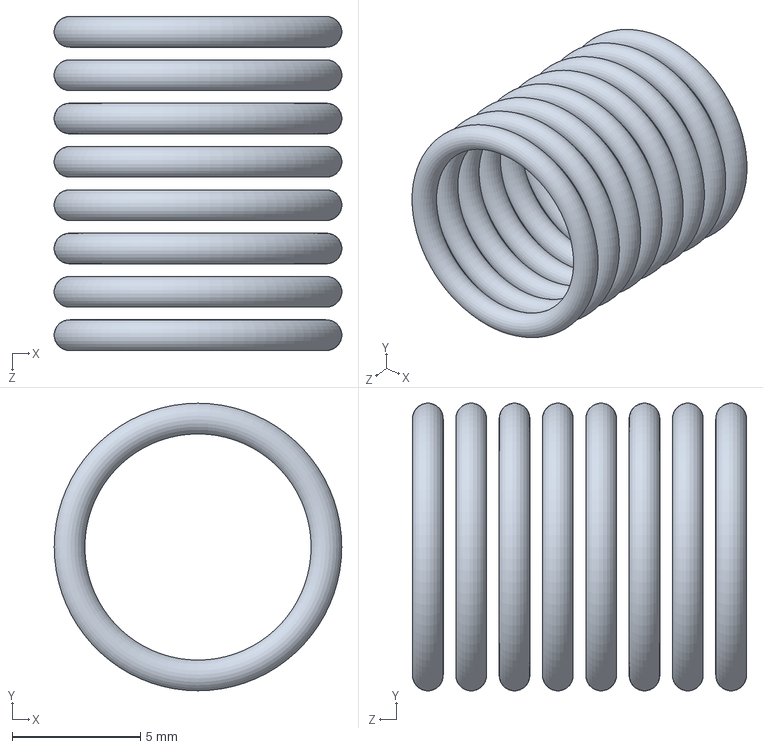
[picture p12: CAD file, 2026-11-02]
小型偏心柱塞泵/sw/BP07_spring_inst.SLDPRT
11.2 x 11.2 x 13.0 mm
