GBK-com/Delumenyu/小型偏心柱塞泵/sw/BP05_portplate.SLDPRT

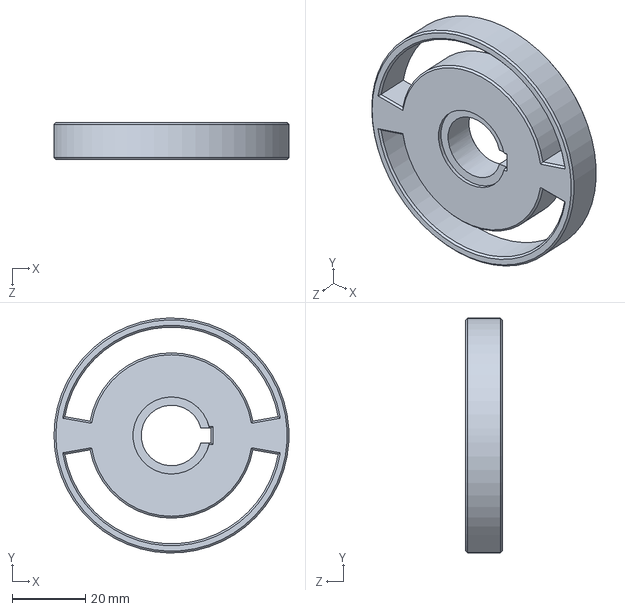
[picture p13: CAD file, 2026-11-02]
小型偏心柱塞泵/sw/BP05_portplate.SLDPRT
64.0 x 64.0 x 10.0 mm
