GBK-com/Delumenyu/小型偏心柱塞泵/sw/STD_oring_10x18.SLDPRT

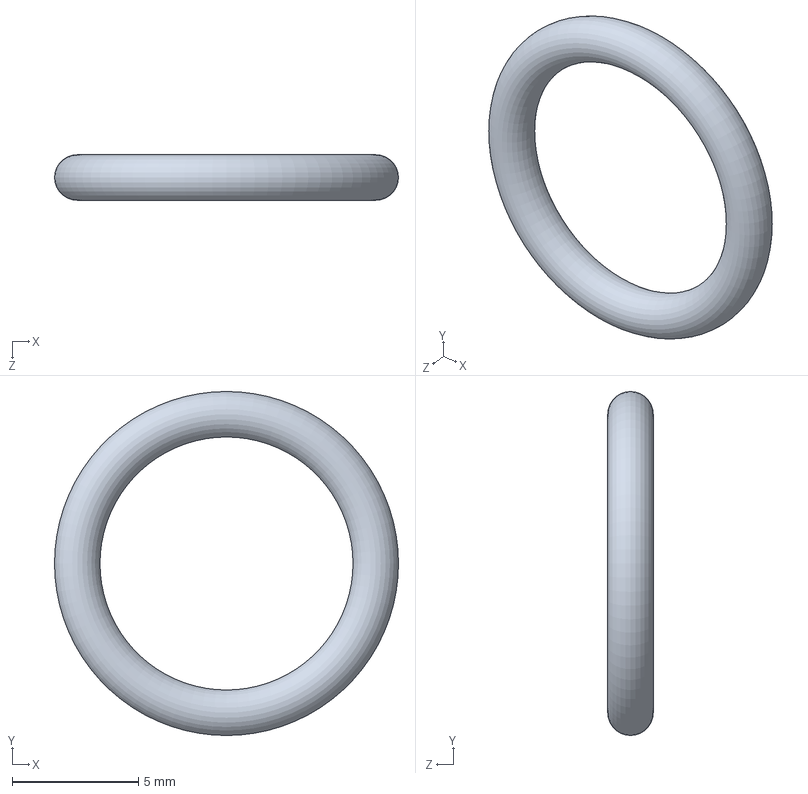
[picture p14: CAD file, 2026-11-02]
小型偏心柱塞泵/sw/STD_oring_10x18.SLDPRT
13.6 x 13.6 x 1.80 mm
