GBK-com/Delumenyu/小型偏心柱塞泵/sw/BP02_ecc_shaft.SLDPRT

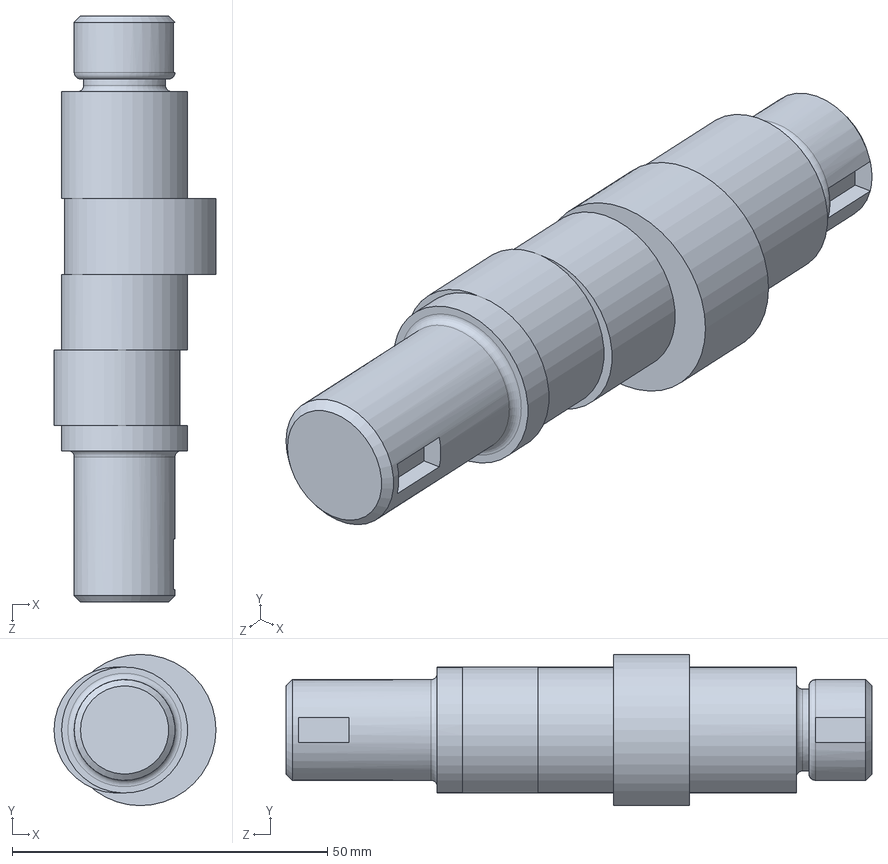
[picture p15: CAD file, 2026-11-02]
小型偏心柱塞泵/sw/BP02_ecc_shaft.SLDPRT
25.7 x 24.0 x 93.0 mm
