GBK-com/Delumenyu/小型偏心柱塞泵/sw/STD_screw_M5x20.SLDPRT

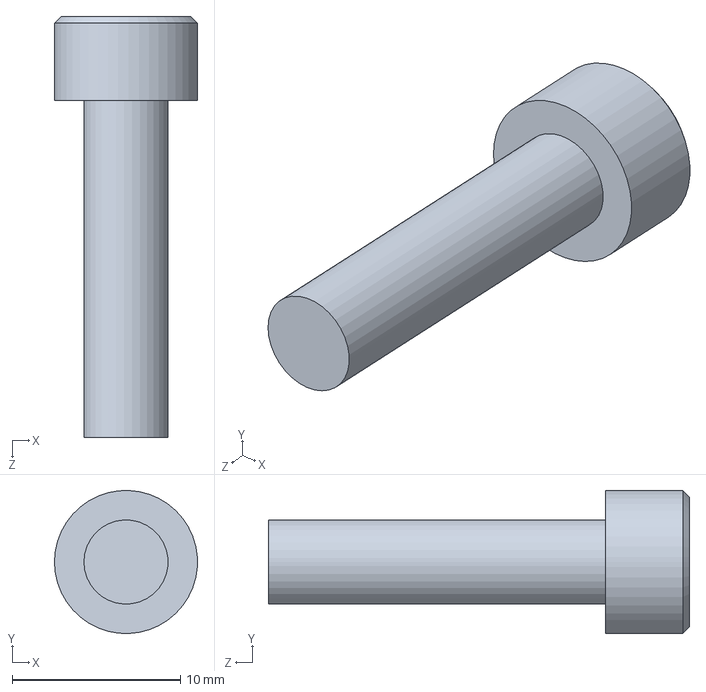
[picture p16: CAD file, 2026-11-02]
小型偏心柱塞泵/sw/STD_screw_M5x20.SLDPRT
8.50 x 8.49 x 25.0 mm
