GBK-com/Delumenyu/(list of files, cad)

Other CAD files:
小型偏心柱塞泵/cad/BP00_装配图.dxf
小型偏心柱塞泵/sw/BP03_plunger.SLDPRT
小型偏心柱塞泵/cad/BP00_装配图.dwg
小型偏心柱塞泵/cad/BP01_泵体.dwg
小型偏心柱塞泵/cad/BP02_偏心轴.dwg
小型偏心柱塞泵/cad/BP05_配流盘.dwg
小型偏心柱塞泵/sw/STD_screw_M5x30.SLDPRT
