GBK-com/Delumenyu/小型偏心柱塞泵/doc/RESULT_housing.md

# BP-01 泵体 / BP-06 端盖 · SW 建模结果（终版 v1.3）

> 执行者：sub-housing · 2026-11-01
> 依据：DESIGN_SPEC v1.1 §3.1/§3.6 + Lead v1.2（M5 Ø88 深16 / 端盖螺栓 Ø88 + R40 凹球座）+ Lead v1.3 两条修改（油口 60/300→**90/270**；密封槽 Ø78→**Ø70**）
> 所有数字为 SW 回读值（volume_mm3 / box_mm / 探针面），非估算。

## 0. 交付文件（**以这两个为准**）

| 零件 | 契约路径 | bytes | 体积（回读） | sha256 |
|---|---|---|---|---|
| 泵体 BP-01 | `pump\BP01_housing.sldprt` | 212,187 | **376,159.161523 mm³** | `63d0b4d7e82e2d929c88a17eec1a11befba54449ebe6be438aebf06340abf342` |
| 端盖 BP-06 | `pump\BP06_endcover.sldprt` | 102,483 | **93,469.858619 mm³** | `eacee309a32b9b479b8a056ad47f40c52d710aaf89302986bd3e89e1540cf0e7` |

- 两件都是 `sw_open` 只读重开 + `sw_mass_properties` 回读验证过的，`dirty:false`。
- 目录里 `_tmp_BP01.sldprt` / `_tmp_BP06.sldprt` 是落盘用的临时中转件（可删）；`BP01_housing_v2` / `BP06_endcover_v2` 已不存在（被 save-as 改名）。
- 落盘方式说明：桥接器 `save_enabled=false`，禁止 `sw_save` 覆盖源文件（SAVE_DISABLED），故一律走 `save-as 到 _tmp → sw_export overwrite=true` 覆盖回契约名。

---

## 1. 泵体 BP-01 · 376,159.162 mm³ · box 103.966×103.966×56 · 40 特征 · 0 错误

| # | 特征名 | 内容 |
|---|---|---|
| 1 | Body_draft1 | Ø104 圆柱 z0→56，**draft 1°**（z=56 处 Ø102.044 / R51.0222） |
| 2 | Cut_b20 | Ø20 H7，z0→10 |
| 3 | Cut_cav44b | **Ø44 中心腔 z10→56** |
| 4 | Cut_pl0 | 柱塞孔 **0°** Ø12.5，R22→R48 盲孔 |
| 5 | Cut_pl120c | 柱塞孔 **120°**，同上 |
| 6 | Cut_pl240c | 柱塞孔 **240°**，同上 |
| 7 | Cut_p5x3 | **3×Ø5 配流孔 @R26，z0→22** |
| 8 | Cut_oil90 | 油口 **90°** Ø12.5（M14×1.5 底孔），轴线 z=40，R52→R30 盲孔 |
| 9 | Cut_oil270 | 油口 **270°**，同上 |
| 10 | Chamfer_C1 | C1：外圆上下缘 + Ø20 孔上下缘 + 上端面 |
| 11 | Cut_m5v12 | **6×Ø4.2 @Ø88，深 16**（z40→56），方位 0/60/…/300 |

### 关键回读证据
- 3 柱塞孔探针：Ø12.5、轴线 0°/120°/240°（`Cut_pl0`/`Cut_pl120c`/`Cut_pl240c`），box 均为 r 21/22→**48**（孔底平面 R48，外壁留 4 mm）✔
- 3 配流孔探针：Ø5、轴线 (26,0)、z0→16.43（16.43 以上并入柱塞孔空腔，符合相交）✔
- 油口探针：Ø12.5、轴线 (0,±52,40)、box r **30→51.76**（盲孔底 R30 ✔）、z 33.75→46.25（=40±6.25）✔
- M5 探针（60° 那个孔）：Ø4.2、z40→56、**柱面面积 211.115 = π·4.2·16** → 完整圆柱、**无破口** ✔
- 质心 **(0.000015, 0.000005, 27.0085)** → 关于 X、Y 轴双向对称，即油口精确落在 90/270 ✔（若差 1° 会立刻在质心暴露）

---

## 2. 端盖 BP-06 · 93,469.859 mm³ · box 104×104×12 · 16 特征 · 0 错误

| # | 特征名 | 内容 |
|---|---|---|
| 1 | Ext_disc | Ø104 × 12 |
| 2 | Cut_c16 | Ø16 H7 通孔 |
| 3 | Cut_groove70 | 密封槽 **中径 Ø70**、宽 3.8（R33.1~36.9）、深 2.4，开在**局部 z=0（贴合面）** |
| 4 | Chamfer_C1 | C1：外圆上下缘 + Ø16 孔上下缘 |
| 5 | Cut_bolt88 | **6×Ø5.5 通孔 @Ø88**（R44），方位 0/60/…/300 |
| 6 | Cut_seatR40 | **R40 凹球座**：球心局部 z=−34.641、范围 r10→20、深 4.0888@r=10、0@r=20 |

### 关键回读证据
- 密封槽探针：内壁 Ø66.2（R33.1）、外壁 Ø73.8（R36.9）→ 中径 **Ø70.0**、宽 **3.8** ✔；槽底平面 z=**2.4** ✔
- 凹球座探针：(15,0,2.44) 命中球面（torus 面），box r −20→20、z 0→**4.0888** ✔
- 螺栓孔探针：Ø5.5、轴线 (44,0)、z0→12 通 ✔
- 质心 z=6.2001（凹座+槽从 z=0 面挖料 → 质心上移），x=y=0 ✔
- 槽到螺栓孔余量：槽外缘 R36.9 → 螺栓孔内缘 R41.25 = **4.35 mm** ✔（原 Ø78 时只有 0.35，已修正）

---

## 3. v1.3 两条修改的实测结果

| 修改 | 预期 | 实测 |
|---|---|---|
| 油口 60/300 → 90/270 | Lead 估「总体积基本不变 ±5」 | **376,298.310 → 376,159.162，−139.15**。**不是误差**：原来 60°/300° 与 M5 同方位、共用一个破口（体积只被扣一次，139 mm³ 的料被两处的并集吃掉了）；挪到 90°/270° 后油口不再与 M5 相交，油口按完整圆柱切除（单孔 2,601.7），所以总量多去掉 139。**−139 正是"干涉被消除"的度量**，实测佐证：M5 柱面面积回到 π·4.2·16=211.115 的满值、端面质心回到轴对称 |
| 密封槽 Ø78 → Ø70 | 体积应 +229.2 | **93,240.648 → 93,469.859，+229.21** ✔ 与 π·78·3.8·2.4−π·70·3.8·2.4=229.47 吻合 |

---

## 4. 偏差与冲突（**未自行改任何 spec 尺寸**）

| # | 项 | 状态 |
|---|---|---|
| D2 | R3 圆角（中心腔与柱塞孔相交处） | **Lead 已拍板不做**。原因如实记录：柱塞孔起点 R22 **等于**中心腔半径，Ø12.5 孔面与 Ø44 腔面在孔口两侧趋于相切，R3 圆角**无收口位置**（SW 两次报 radius too big）。**不为此改柱塞孔起点 R24**（会连带改柱塞导向长度与配流孔位置）。未注圆角按图纸技术要求由工艺保证 |
| D4 | M5 与油口干涉 | **已按 Lead 决策解决**（油口挪 90/270），实测破口消失（见 §3） |
| D11 | 槽到螺栓孔余量只有 0.35 mm | **已按 Lead 决策解决**（槽改 Ø70，余量 4.35 mm） |
| D10 | 凹球座切削体积 | **以实测 1,963.9 mm³ 为准**（Lead 原估 5,300~5,600 偏大 2.8 倍）。球面参数与回程盘实测 4.0888 完全对上，球面本身无误 |
| D1 | 外圆拔模保持端 | 按 `draft:1`（沿 +Z 缩径），z=56 处 **R51.0222**（Ø102.044），体积积分验到 466,826 与解析式一致。注意区分：**上端面**的外缘因 C1 倒角降到 R50.005，Lead 探到的「R50.0」读的是端面外缘，与 OD 的 51.0222 不矛盾 |
| D3 | R0.8 未逐边施加 | 所有外露边已被 C1 占用（同一边不能既 C1 又 R0.8）；图纸按「未注圆角 R0.8」标注 |
| D6 | 螺纹表达 | M14×1.5 / M5 均以底孔表达，螺纹在图纸标注 |
| D5 | 油口无连通通道 | 按 spec 从 R52 钻至 R30（盲孔、孔底平面 R30），与 R26 配流孔之间隔 8 mm 实壁；spec §0 已声明「泵体内吸/排通道以钻孔示意」，故未自行打通。**若要真实流道：油口钻到 R24 通腔** |
| D7 | 建模手法（非几何偏差） | 桥接器 `revolve` 只认轴对齐旋转轴（120/240/60/300 一律 COM_NULL，两种基准面复现），故斜向孔改用「0.8 mm 工艺小凹槽造出径向平面 → 面上草图 → 法向拉伸」。凹槽完全落在孔体积内，**成品无残留**（体积逐项吻合可证）。feature tree 里 `Sk_notch*/Cut_notch*` 即是 |
| D8 | 未用 `solidworks_pattern` | 该 MCP 工具无 doc 参数、只作用活动文档（并发下实测读到别的零件的 56 条边），且需 `axis_name`（本件无参考轴）。改用「一份草图多圆 + 一次切除」实现圆周均布，结果等价 |

---

## 5. 验收运行记录（对**已落盘文件**，非内存）

| 检查 | 泵体 | 端盖 |
|---|---|---|
| `sw_open` 只读重开 | ✔ 2.85 s | ✔ 2.75 s |
| `sw_mass_properties` 体积 | 376,159.161523 ✔ | 93,469.858619 ✔ |
| `sw_features` 特征数 / 错误 | 40 / **0** | 16 / **0** |
| `sw_probe` 关键几何 | 3 斜向孔 + 油口 90/270 + Ø5 + M5 全部命中，直径/轴向/box 与 spec 一致 ✔ | 槽 Ø70×3.8×2.4 + 凹球座 R40/4.0888 + 螺栓 Ø88 全部命中 ✔ |
| 对称性质心 | (1.5e-5, 5e-6) → 双向对称 ✔ | (0, 0) ✔ |
