GBK-com/Delumenyu/小型偏心柱塞泵/doc/RESULT_plunger.md

# sub-plunger 交付报告 — 柱塞 BP-03 / 回程盘 BP-04 / 标准件 4 件

任务 board：`task-3`（owner: sub-plunger）
日期：2026-11-01
依据：`spec/DESIGN_SPEC.md` **v1.1** + Lead 在 2026-11-01 会话内的**三次**更正（弹簧 v1.1 规格、O 型圈 88×3 → 75×3 → **67×3**、回程盘 BP-04 重构为「泵体上端封压盘」并把密封槽 **Ø78 → Ø70**）
所有数值均为 SW 桥接 `sw_build` / `sw_probe` / `sw_save` **回读实测值**，非估算。

---

## 0. 一句话结论

| **现行交付 6 件** | `BP03_plunger` · `BP04_retainer_v2` · `STD_screw_M5x20` · `STD_screw_M4x10` · `STD_oring_67x3` · `STD_oring_10x18` |

**现行件全部建模完成、`sw_save` 成功、`sw_view` 目检通过**，均在 `C:\Users\谷博康\Documents\dsh-solidworks\pump\`。
**弹簧 BP-07 不由我产出**（见 §4）。BP-04 已经历 3 次改版：Ø40 球面自定心盘（作废）→ Ø104 封压盘/槽 Ø78（因密封槽与沉头孔重叠而作废）→ **Ø104 封压盘/槽 Ø70（现行）**。
另有 2 个**保留但作废**的文件：`BP04_retainer.sldprt`（Ø78 旧版，被装配体占用未能覆盖）、`STD_oring_75x3.sldprt`（配旧 Ø78 槽）。

---

## 1. 交付清单（实测数据）

| # | 文件 | sha256 | volume_mm³ | box_mm (size) | z 范围 | 字节 |
|---|---|---|---|---|---|---|
| 1 | `pump\BP03_plunger.sldprt` | `ced2dc057a3f3ab57e2cbe358b5d7c1ba9adf064ceb8f45101e8a801b17f8320` | **2462.415505** | 12 × 12 × 29 | −5 → 24 | 134,512 |
| 2 | `pump\BP04_retainer.sldprt` ← **现行（槽 Ø70 + 6 孔齐全）** | `f8ecf160c09274e05641fe422c62c632ec546c5d3496830a3d5d7cb13286fc97` | **46957.427426** | 104 × 104 × 10.088817 | 0 → 10.088817 | 118,399 |
| 2′ | `pump\BP04_retainer_v2.sldprt`（**作废：槽 Ø70 但只有 3 孔，缺 60/180/300 通孔**） | `ba4bea99f9262909651e4d6197aa23b58ec9c695ae19bbbab35d92163806f46c` | 47385.076726 | 104 × 104 × 10.088817 | 0 → 10.088817 | 118,322 |
| 2″ | ~~BP-04 的 Ø78 旧版~~（同路径已被覆盖，历史哈希 `9b7f22d6fceae9f51e6988fa65689be50e39a33e903a4cd9d6f29a0d2dd3b892`） | — | 47212.433915 | 104 × 104 × 10.088817 | 0 → 10.088817 | 117,114 |
| 3 | `pump\STD_screw_M5x20.sldprt` | `900f165e2d42432c06e62eb8f5ae9a6007955a8972356716ac310c141252cd50` | **631.603273** | 8.5 × 8.5 × 25 | 0 → 25 | 95,829 |
| 3′ | `pump\STD_screw_M5x30.sldprt` ← **新增（配 0/120/240 沉头孔）** | `cddea2eb05554fdce4a4a6d2c868cc05b7032a62eb49678b1c1df84556cdae65` | **827.952814** | 8.5 × 8.5 × 35 | 0 → 35 | 94,337 |
| 4 | `pump\STD_screw_M4x10.sldprt` | `6ab38d01db5c6dcf1c05059c785d830d054b0e2eddd0ab794b75fac6f72c3410` | **261.415732** | 7 × 7 × 14 | 0 → 14 | 91,380 |
| 5 | `pump\STD_oring_67x3.sldprt` ← **现行（配 Ø70 槽）** | `bee91d399e7476f4523ac13f4572abc4b7d247f97ab529a630f865ffee9dac07` | **1554.462693** | 73 × 73 × 3 | −1.5 → 1.5 | 101,340 |
| 6 | `pump\STD_oring_75x3.sldprt`（按 Lead 指示保留，明细栏不再引用） | `670608f5ae960f83976e7f3f7dd8215cde998d0bad5b5b878221e40d6de17321` | **1732.115572** | 81 × 81 × 3 | −1.5 → 1.5 | 100,300 |
| 7 | `pump\STD_oring_10x18.sldprt` | `17d351c2fcd68ebfb24459df6690684d5cc7d0fdb1d6afd83bad64851de28d07` | **94.333679** | 13.6 × 13.6 × 1.8 | −0.9 → 0.9 | 115,732 |

> **文件命名说明（已解决）**：上一轮 `BP04_retainer.sldprt` 被 Lead 打开的 `装配体1` 占用，曾另存 `_v2`；本轮（Lead 关闭装配体后）**规范名已可直接覆盖写入**，现行件即为 `BP04_retainer.sldprt`。`_v2` 与 Ø78 旧版均已作废，**装配体只可引用 `BP04_retainer.sldprt`**。

表面积（回读）：BP-03 1172.523594 / **BP-04(现行) 20281.210114** / M5×20 593.253795 / **M5×30 750.333428** / M4 303.815389 / **O67 2072.616924** / O75 2309.487430 / O10 209.630397 mm²

---

## 2. 逐件特征与校验

### 2.1 柱塞 BP-03（3 件，建 1 件）
局部坐标：轴线 = Z，球头在 z=0 端，+Z 朝外。**总长 29（z −5 → 24）**。

| z 范围 | 特征 | 实现 |
|---|---|---|
| −5 → 0 | 球头 R5（球心 z=0，半球凸出） | 剖面四分之一圆弧，绕 Z 旋转 |
| 0 → 18 | Ø12 圆柱 | 同一次 revolve |
| 8 → 10.4 | 密封环槽：槽底 Ø8.6，宽 2.4 | 同一次 revolve 轮廓内做出（未用 cut，避免多一层特征） |
| 18 → 24 | Ø8 导杆 ×6 | 同一次 revolve |

- **建模方法**：`Sketch_plunger`（上视基准面，12 段封闭剖面：球头弧 + 12 段阶梯）→ `Rev_plunger` 360° **一次成型**；再加 `Chamfer_C05`（C0.5 × 3 个端面：z=24 杆端、z=18 台肩、z=0 球头根部环面）。
- **体积校验**：理论解析 2467.2 mm³ → 实测 **2462.415505**，差 4.70 = 3 处 C0.5 倒角所切体积，**吻合**。
- **尺寸校验**：box 12 × 12 × 29 ✔（Ø12 最大外径、z −5/24 两端）；`sw_view` isometric 目检：球头 / 环槽 / 台阶 / 杆端倒角形态均正确。

### 2.2 回程盘 BP-04（1 件，重构版：泵体上端封压盘，不随轴转）
局部坐标：盘体占 z 0 → 6，装配于 [0,0,56]（z 56→62）。

| 特征 | 规格 | 实测校验 |
|---|---|---|
| 盘体 | **Ø104 × 厚 6** | box x/y = 104 ✔ |
| 中心孔 | **Ø20** 通孔 | 孔壁探针：圆 Ø20 @ z=10.088817 ✔ |
| 上表面球冠 | **R40 凸，范围 Ø40（r 0→20）**，平环 r 20→52 在 z=6 | r=10 处 z=10.088817，r=20 处 z=6.000（探针 + box max 双证） |
| 沉头孔 ×3 | **Ø5.5 通 / Ø10 沉头深 5.5**，圆 **Ø88**，方位 0/120/240°，**开在上表面（z=6 侧）** | 探针：Ø10 壁 box z=0.5→6、Ø5.5 壁 z=0→0.5 ✔ |
| **通孔 ×3（本轮新增）** | **Ø5.5 通**，圆 **Ø88**，方位 **60/180/300°**，无沉头 | 探针三孔：Ø5.5、z 0→6 全程、圆柱面 103.672558=π·5.5·6；轴线 R44 @60/(22,38.105)、@180(−44,0)、@300(22,−38.105) ✔ |
| 6 孔分布 | **0/120/240 沉头（M5×30 穿过并压紧）+ 60/180/300 通孔（M5×20 仅穿过）** | 与端盖 `Cut_bolt88`（Ø5.5 @R44）**同圆同位** ✔；与泵体 `Cut_m5v12`（Ø4.2 底孔 @R44）**同圆** ✔ —— 三件全部 Ø88，见 D13 |
| 下表面密封槽 | 环槽 **中径 Ø70，宽 3.8（Ø66.2/Ø73.8），深 2.4** | 槽底环面积实测 **835.663646** mm² = π(36.9²−33.1²)=835.664 ✔；外壁 Ø73.8、内壁 Ø66.2 探针实测 ✔ |
| 密封槽与沉头孔的壁 | **R36.9 → R39 = 2.1 mm 实壁** | R38 处探针命中实心底平面 z=0（Ø78 旧版此处是泄漏通道） |
| 未注倒角 | **C1** | 外圆上下两端 1×45°（`Chamfer_C1`） |

**体积对表（逐项分解，全部为解析值，与实测闭合）**

| 项 | mm³ |
|---|---|
| 盘体 π/4·104²·6 | +50,969.2 |
| 球冠相对 z=6 平面的凸出（r 10→20，解析积分） | **+1,963.2** |
| 中心孔 Ø20 通 | −1,885.0 |
| 3 × Ø5.5 沉头通孔（0/120/240） | −427.6 |
| **3 × Ø5.5 纯通孔（60/180/300，本轮新增）** | **−427.65** |
| 3 × Ø10 × 5.5 沉头台阶 | −903.9 |
| **Ø70** × 3.8 × 2.4 密封槽 | −2,005.6 |
| 外圆 C1 倒角 ×2 端 | −268.7 |
| **合计** | **46,957.4** |
| **实测** | **46,957.427426** |
| **差** | **+0.003** ✔ 闭合 |

> 上一版（3 孔，47,385.076726）与本次（6 孔，46,957.427426）之差 = **427.649300**，与解析 3×π×2.75²×6 = 427.649452 差 0.000152 ✔

### 2.2a 泄漏缺陷审计（Ø78 → Ø70 的定量依据）

Lead / sub-housing 指出的缺陷：旧槽（中径 Ø78，宽 3.8，跨 **R37.1~R40.9**）与 3 个 Ø10 沉头孔（Ø88 分度圆 R44，跨 **R39~R49**）径向重叠 **R39~R40.9 = 1.9 mm**，而沉头深 5.5、板厚 6 → 密封带被打穿，形成泄漏通道。**该判断成立。**

定量闭合（三级证据互相印证）：

| 证据 | 数值 |
|---|---|
| ① 两版实测体积差（同一建模脚本，只改槽径） | 47,385.076726 − 47,212.433915 = **+172.643** |
| ② 两版槽的完整环体积差 π·(78−70)·3.8·2.4 | **229.21** |
| ③ 差额 ②−① = 旧槽当年「已经不存在」的那部分体积 | **56.57** |
| ④ 数值积分：旧槽环面 ∩ Ø10 孔，每孔面积（按半径切片精确角宽积分，200k 片） | **9.924 mm²** |
| ⑤ ④ × 3 孔 × **有效重叠深度 1.9**（沉头从 z=0.5 起，槽从 z=0 起，只在 z 0.5→2.4 重叠） | **56.57 mm³** |

③ 与 ⑤ **完全相等（差 0.00）**。结论：旧版那条槽有 **56.57 mm³ / 横截面 3×(9.924 mm²) 的密封带实体缺失**，这就是泄漏通道的体积当量。Lead 预期的 47,441.6 之所以差 56.6，是因为按「旧槽完整环 2,234.8」算，而那 56.57 在旧版里根本没被切到（早已被沉头孔挖空）—— **我的实测 47,385.08 是对的，Lead 的 47,441.6 忽略了这一项**。

> Lead 给的预估 ≈45,700 与实测差 1,512，**原因是球冠只加了约 180 而非 1,963**，不是孔系偏差（Lead 已确认接受实测值）。

**球面接口精确值（供端盖配作，Lead 已按此反解确认）**
- 球心：局部 **z = −28.641**（装配 **z = 27.359**），R40
- 两点定球校验：r=10 → 27.359+√1500 = 66.089（= 56+10.089）✔；r=20 → 27.359+√1200 = 62.000 ✔
- 端盖凹球座：R40、球心装配 z=27.359、范围 r 10→20、最大凹深 **4.089**（r=10 处），r=20 处深 0

### 2.3 内六角圆柱头螺钉 M5×20（GB/T 70.1 等效件，6 件建 1 件）
- 头 Ø8.5 × 5（z 0→5，头端面在 z=0）+ 杆 Ø5 × 20（z 0→25，总长 25）+ 内六角对边 **4**（深 3）+ 头端 C0.4 倒角。
- **螺纹简化为光杆 Ø5**（明细栏注 M5）。
- 校验：box 8.5 × 8.5 × 25 ✔；体积 631.603273（无内六角时应为 673.5，差 41.9 = 六角坑 13.856 mm² × 3 ✔）。

### 2.4 内六角圆柱头螺钉 M5×30（GB/T 70.1 等效件，本轮新增 → 配 0/120/240 沉头孔）
- 与 M5×20 **结构完全一致**：头 Ø8.5 × 5（z 0→5）+ 杆 Ø5 × **30**（z 0→**35**）+ 内六角对边 **4**（深 3）+ 头端 C0.4 倒角；**螺纹简化光杆 Ø5**。
- 校验：box 8.5 × 8.5 × **35** ✔；体积 **827.952814**（无内六角时应为 869.8）。
- **增量闭合**：827.952814 − 631.603273 = **196.349541**，解析 π·2.5²·10 = **196.349541** ✔ 精确（只多了 10 mm 杆）。

### 2.5 内六角圆柱头螺钉 M4×10（GB/T 70.1 等效件，3 件建 1 件）
- 头 Ø7 × 4 + 杆 Ø4 × 10（总长 14）+ 内六角对边 **3**（深 2）+ 头端 C0.4。
- **螺纹简化光杆 Ø4**。
- 校验：box 7 × 7 × 14 ✔；体积 261.415732。

### 2.6 O 型圈 67×3（等效件，1 件，**配 BP-04 Ø70 槽**）
- **截面圆 Ø3，圆心距轴 R35**（= (67+3)/2）→ `revolve` 成圆环。
- 校验：box **73 × 73 × 3** → 外径 73 = 67 + 2×3 ✔、线径 3 ✔；体积 **1554.462693**（理论 2π²·35·1.5² = 1553.9，差 0.04%）✔
- **槽配合校核**：圈占径向 R33.5~36.5；槽占 R33.1~36.9 → 两侧各留 0.4 余量 ✔；压缩率 (3−2.4)/3 = **20%** ✔（NBR 静密封 15~30% 合理）
- 旧 `STD_oring_75x3.sldprt`（R39，配 Ø78 槽）按 Lead 指示**保留但作废**，明细栏已改指 67×3。

### 2.7 O 型圈 10×1.8（等效件，3 件建 1 件）
- **截面圆 Ø1.8，圆心距轴 R5.9**（= (10+1.8)/2）。
- 校验：box 13.6 × 13.6 × 1.8 → 外径 13.6 = 10 + 2×1.8 ✔；体积 94.333679（理论 2π²·5.9·0.9² = 94.38）✔

---

## 3. 偏差与冲突（必须随图说明）

| # | 项 | 与 spec 的差异 | 处置与依据 |
|---|---|---|---|
| D1 | **BP-04 球冠范围 Ø40 而非 Ø60** | Lead 重构规格写「R40 球面仅存在于 Ø60 范围」 | **几何上不存在**：R40 球心 z=−34 时，r=30 处球面 z=−7.54（低于盘底 7.54）；R40 球面只在 r≤21.07（Ø42.1）内高于 z=0。且 Lead 自算的「凸起 5.36」= 40−√(40²−20²) 正是 Ø40 的数。**Lead 已回复确认「你选 Ø40/凸起 5.36 是正确的」**。若日后要 Ø60 范围 + 5.36 凸起，R 须改 86.6；若要 Ø60 + R40 则凸起 13.54、端盖 12 厚会被打穿 |
| D2 | **BP-04 总高 10.088817（含球冠凸出 4.0888）** | 设计要求厚 6（z 56→62） | **Lead 裁定路线 1：保留球冠**。`BP-04 总高 10.0888（含球冠凸出 4.0888），装配后凸入端盖凹座，端盖凹座深 4.089` |
| D3 | **BP-04 中心孔 Ø20 未注 H9 公差** | spec 旧版写 Ø20 H8；重构版写 Ø20 H9 | 模型为 Ø20 名义尺寸，**未在 SW 内加公差标注**（SW 模型不带公差，公差进图纸） |
| D4 | **BP-04 沉头深度基准** | 规格「深 5.5」未指明基准面 | 取**上表面（局部 z=6）为基准**，实做 z 0.5→6、留底 0.5；已探针验证。Lead 已确认「保持不变」 |
| D5 | **BP-03 未做未注圆角 R0.8** | spec §3.3「未注圆角 R0.8」 | 只做了 3 处端面 C0.5 倒角。R0.8 需逐边指定，全局 fillet 会破坏密封环槽边缘（槽宽 2.4、深 1.7，R0.8 会使槽口相交）。**演示级取舍，已在体积校验中显式计入倒角量** |
| D6 | **标准件螺纹为光杆** | 真实 GB/T 70.1 有螺纹 | **等效件**，明细栏须注「等效」；M5 杆标 Ø5、M4 杆标 Ø4，图纸按 M5/M4 标注 |
| D7 | **O 型圈规格 88×3 → 75×3 → 67×3（两次变更）** | spec v1.1 表内仍写 88×3 | 按 Lead 两次更正执行：①88→75（端盖槽与 Ø92 螺栓孔径向重叠）；②75→67（配 BP-04 槽 Ø78→Ø70）。已产出 `STD_oring_67x3.sldprt`（现行）与 `STD_oring_75x3.sldprt`（保留作废），**未产出 `STD_oring_88x3.sldprt`** |
| D8 | **M4×10 螺钉件保留但当前装配未使用** | 重构后 BP-04 改用 M5×30 | 按 Lead 指示「保留也行，明细栏里不会有它」，文件保留 |
| D9 | **旧 BP-04（Ø40 球面自定心盘）已被覆盖** | 曾是 sha256 `792fbd73…`，体积 2314.77 | 该设计被 Lead 判定「轴装方案整体无解」→ 重构为封压盘。旧文件已被同路径覆盖，磁盘上不存在 |
| **D10** | **BP-04 密封槽 Ø78 → Ø70** | Lead 2026-11-01 第 4 次更正 | **缺陷修复**：旧槽跨 R37.1~40.9 与 Ø10 沉头孔（R39~R49）重叠 1.9 mm，沉头深 5.5/板厚 6 → 密封带被打穿成泄漏通道，实测缺失体积 **56.57 mm³**（§2.2a 三级证据闭合）。改 Ø70 后槽跨 R33.1~36.9，到沉头孔内缘 R39 留 **2.1 mm** 实壁（R38 探针命中实心底面为证） |
| **D11** | ~~BP-04 文件名 = `_v2`，非规范名~~ **已解决** | §8 约定为 `pump\BP04_retainer.sldprt` | 上一轮规范名被 Lead 的 `装配体1` 占用故另存 `_v2`；本轮装配体已释放，**规范名已直接写入成功**。`_v2` 作废，装配体只可引 `BP04_retainer.sldprt` |
| **D12** | **BP-04 补 3×Ø5.5 通孔（60/180/300 @Ø88）** | 原只有 3 个沉头孔（0/120/240） | **缺陷修复**（Lead 发现）：回程盘 Ø104 盖住整个上端面，端盖 6 颗 M5 中 60/180/300 三颗会穿过实心铝。补孔后 6 孔分布 = 3 沉头（M5×30 压紧）+ 3 通孔（M5×20 仅穿过）。体积 47,385.076726 → **46,957.427426**，差 427.649300 vs 解析 427.649452 ✔ |
| **D13** | ~~螺栓孔圆不一致：端盖 Ø92 vs 泵体 Ø88~~ → **虚警，已排除** | 我误引旧版 spec 的 Ø92 | **我量错文件了**：我探针的是 `BP06_endcover_v2.sldprt`（过期中间备份，特征 `Cut_bolt6`，轴线 (46,0,12)=Ø92）。Lead 指出契约件是 `BP06_endcover.sldprt`，我复验确认：特征名 **`Cut_bolt88`**、Ø5.5、轴线 **(44,0,12)=Ø88**、圆柱面 207.345=π·5.5·12 ✔。**三件（泵体 Cut_m5v12 @Ø88 / 端盖 Cut_bolt88 @Ø88 / BP-04 六孔 @Ø88）完全一致，无冲突，未做任何改动。** 另：泵体 `Cut_m5v12` 深 16（到 z=40）是 v1.2 的有意设计（容纳穿过端盖+回程盘的 M5×30），我误判为偏离，已更正 |

---

## 4. 弹簧 BP-07（3 件）— **不由我产出，未创建文件**

- 按 Lead 2026-11-01 决定：**`pump\BP07_spring.sldprt` 由 Lead 负责**（内部几何内核做真螺旋扫描 → 导出 STEP → SW 导入 → 保存），**我没有创建也没有留下任何 BP07 文件**。
- 我在该件上唯一留下的是**失败记录**（供后续不再踩）：
  1. `sw_build` 确无 sweep / pattern（只有 sketch/extrude/revolve/fillet/chamfer/shell/plane/delete）。
  2. MCP 工具 `solidworks_build_round_sweeps` 签名 = `{params:{expected_document_path, spec_path}}`，但 **spec JSON 的 schema 在任何文档中都查不到**（`README.md` / `llms.txt` / `protocol/tools.json` 均无此工具）。用空 JSON `{}` 试探时调用**超时 >2 min** 并把 SW 卡到 `command_in_progress=true`。**结论：此路不通，勿再试。**
  3. 未采用「圆环叠片冒充弹簧」的近似方案 —— Lead 改为自己做真螺旋体后，该近似已无必要。
- 规格终版（Lead 定稿，我未建模，仅记录）：线径 Ø1.2、中径 Ø10、自由长 17、总圈 8 / 有效圈 6、节距 2.633、右旋、压并 9.60 < 最小工作长度 10.5。

---

## 5. 建模过程中被实测纠正的错误（留档）

1. **BP-04 沉头切成反方向**：先用「偏移平面 z=0.5 + `through_all`」做沉头，SW 自动判向选了 **−Z**，只切掉 z 0→0.5 的 0.5 mm；体积比解析值多 836 mm³ 才暴露。探针证实（Ø5.5 孔壁 z 区间 0.5→6、r=5 处无 Ø10 壁）。**改用 `end:"mid_plane"` + `depth:6.5`（居中于 z=3.75 平面）方向无关地切**，重建后体积 47,212.43，与解析 47,212.7 闭合。
   → 经验：**从偏移平面做 `through_all` 切不可信任方向，用 `mid_plane` 居中切**。
2. **BP-04 球冠验收标准被推翻**：原「球面最高点装配 z=16 与偏心轮点接触」在 Ø20 中心孔存在时不成立（球冠最高点在 r=10 孔口，不是中心）。该结论是回程盘重构的触发点之一。
3. **BP-04 密封槽与沉头孔重叠（我的漏检，由 sub-housing 发现、Lead 复核确认）**：我建 Ø78 槽（R37.1~40.9）时只核了「槽 vs 中心孔 R10」和「槽 vs 沉头**内缘** R39」，**没有核槽与沉头孔在 z 方向的交叠**——沉头从 z=0.5 起、槽从 z=0 起，1.9 mm 重叠区内槽的密封带被挖空，形成泄漏通道（定量 56.57 mm³，见 §2.2a）。
   → 教训：**同轴系零件改孔径后，必须把「新特征 vs 已有全部特征」在三维上逐对核，不能只核径向最近邻**。我此前的体积对表把槽按完整环 2,234.8 计入，而那 56.57 在旧版里根本不存在——**体积对表当时就该暴露这件事**，我把它归到倒角估算误差里了。
4. **BP-04 少 3 个通孔（我的漏检，Lead 在总装时发现）**：端盖有 6 颗 M5（0/60/120/180/240/300），回程盘 Ø104 盖住整个上端面，而我只做了 0/120/240 三个沉头孔 → 60/180/300 三颗会穿过实心铝。**同类错误的第二次复发**：第 3 条是"只核自己的特征间关系、不核配对件"，这条是"只核自己的孔、不核配对件的孔数"。根因相同——**我从没把配对件（端盖）当作校验输入去数一遍**。
   → 教训：**凡"穿过他人零件的孔"，必须以配对件的孔位/孔数/分布为输入逐项对齐**，而不是只按自己拿到的规格建。
5. **被 `_v2` 过期件误导，虚报了一个不存在的冲突（我报错、Lead 纠正）**：我为了查螺栓孔圆，探针了 `BP06_endcover_v2.sldprt`（过期中间备份，Ø92/`Cut_bolt6`），据此报出"端盖 Ø92 vs 泵体 Ø88 差 2 mm、装不进"。Lead 指出契约件是 `BP06_endcover.sldprt`；我复验：`Cut_bolt88`、Ø5.5、轴线 (44,0,12)=**Ø88**，三件一致，**冲突根本不存在**。同时我引用的 "spec §3.1/§3.6 = Ø92" 也是旧版文本（v1.2 已统一 Ø88、螺纹孔深 16）。
   → 教训（**这条是流程级的，比尺寸错更值得记**）：**在报"跨零件冲突"之前，必须先确认自己量的是规范名契约件，不是任何 `_v2`/`_tmp`/`_b` 备份**。查证的对象错了，查证越认真错得越自信。Lead 定过的规矩"只认不带 `_v2` 的规范名文件"我这次没执行，代价是一次假警报 + 浪费了 Lead 的时间去复核。

---

## 6. 独立复核记录（磁盘级，2026-11-01 23:0x）

交付后关闭 6 个文档（全部 `dirty=false`，即内存态 == 磁盘态），再对磁盘文件独立重算 SHA256，与 `sw_save` 保存时返回的哈希逐一比对：

**（第三轮：补 3×Ø5.5 通孔 + 新增 M5×30 之后，2026-11-02 12:1x）—— 最终交付**

| 文件 | 磁盘字节 | SHA256 | 校验方式 |
|---|---|---|---|
| **BP04_retainer.SLDPRT** | **118,399** | `f8ecf160c09274e05641fe422c62c632ec546c5d3496830a3d5d7cb13286fc97` | 字节数与 `sw_save` 返回值**逐字节相同**；磁盘哈希未能重算（文件正被 SW 打开、作为 `PUMP_ASSY` 组件，且我无权限关闭 Lead 的装配体）。**补充证据**：活体探针确认 3 个新孔（Ø5.5、z 0→6、60/180/300 @R44，圆柱面 103.672558=π·5.5·6）与体积 46,957.427426 均如设计 |
| **STD_screw_M5x30.SLDPRT** | **94,337** | `cddea2eb05554fdce4a4a6d2c868cc05b7032a62eb49678b1c1df84556cdae65` | 同上，`sw_save` 返回值 + 字节数一致（文件在 SW 中打开，磁盘哈希未能重算） |
| **BP06_endcover.SLDPRT**（非我的件，为确认可安全删除备份而复核） | 102,483 | `eacee309a32b9b479b8a056ad47f40c52d710aaf89302986bd3e89e1540cf0e7` | 磁盘独立重算 + 活体探针：`Cut_bolt88`、Ø5.5、轴线 (44,0,12)、圆柱面 207.345115=π·5.5·12 ✔ |

> ⚠ **清理动作未完成（权限限制）**：要删除的 `BP04_retainer_v2.SLDPRT`(118,322) 与 `BP06_endcover_v2.SLDPRT`(100,601) 位于 `C:\Users\谷博康\Documents\dsh-solidworks\pump\`，**该目录在我的会话沙箱之外（我的可写工作区只有 `Desktop\sw`）**：`rm` 返回 `Permission denied`，且写入测试 `echo > _dsh_write_test.tmp` 同样被拒 → 确认是沙箱只读，不是文件锁。**我无法提权**，已上报 Lead 由他自己或 sub-housing 删除（其权限范围覆盖该目录）。

**（第二轮：Ø70 槽修复 + O 型圈 67×3 之后，2026-11-01 23:1x）—— 历史**

| 文件 | 磁盘字节 | 磁盘实测 SHA256 | 与 sw_save 返回值 |
|---|---|---|---|
| BP03_plunger.SLDPRT | 134,512 | `ced2dc057a3f3ab57e2cbe358b5d7c1ba9adf064ceb8f45101e8a801b17f8320` | **一致** |
| **BP04_retainer_v2.SLDPRT** | **118,322** | `ba4bea99f9262909651e4d6197aa23b58ec9c695ae19bbbab35d92163806f46c` | **一致** |
| STD_screw_M5x20.SLDPRT | 95,829 | `900f165e2d42432c06e62eb8f5ae9a6007955a8972356716ac310c141252cd50` | **一致** |
| STD_screw_M4x10.SLDPRT | 91,380 | `6ab38d01db5c6dcf1c05059c785d830d054b0e2eddd0ab794b75fac6f72c3410` | **一致** |
| **STD_oring_67x3.SLDPRT** | **101,340** | `bee91d399e7476f4523ac13f4572abc4b7d247f97ab529a630f865ffee9dac07` | **一致** |
| STD_oring_10x18.SLDPRT | 115,732 | `17d351c2fcd68ebfb24459df6690684d5cc7d0fdb1d6afd83bad64851de28d07` | **一致** |

**6/6 通过。**

**（第一轮：改槽之前，2026-11-01 23:0x）—— 历史留档**

| 文件 | 磁盘字节 | 磁盘实测 SHA256 | 与 sw_save 返回值 |
|---|---|---|---|
| BP04_retainer.SLDPRT（Ø78 旧版，现作废） | 117,114 | `9b7f22d6fceae9f51e6988fa65689be50e39a33e903a4cd9d6f29a0d2dd3b892` | **一致** |
| STD_oring_75x3.SLDPRT（配 Ø78，现作废） | 100,300 | `670608f5ae960f83976e7f3f7dd8215cde998d0bad5b5b878221e40d6de17321` | **一致** |

结论：磁盘上的交付物与建模时回读的几何（§1 的 volume/box）严格对应，中途没有被覆盖或损坏。

> 说明：本任务无可运行的测试套件（CAD 建模，非代码）。等效的「验收跑」= 每个特征的 `box_mm` + `volume_mm3` 回读 + 关键面/孔 `sw_probe` 探针 + 磁盘哈希复核 + **解析体积与实测的差分闭合**（§2.2a 的 56.57 三级印证就是这一类证据），五类证据全部在 §1/§2/§6 记录在案。
> 复核后我的文档均已从 SW 关闭，装配时由 Lead 从磁盘重新插入即可。
> **唯 `BP04_retainer.sldprt`（规范名）我无法覆盖**，原因见 D11。

---

## 7. 未做 / 待他人

| 项 | 归属 |
|---|---|
| 弹簧 BP-07 建模 | Lead |
| BP-01/BP-02/BP-05/BP-06 | sub-housing / sub-rotor |
| 总装配 `pump\PUMP_ASSY.sldasm` | Lead |
| 零件图 / 装配图（GB 图层、公差、粗糙度、明细栏） | AutoCAD 子任务 |
| 模型内公差标注（H7/H8/H9、h6、形位公差） | 全部进图纸，SW 模型为名义尺寸 |
