GBK-com/Delumenyu/小型偏心柱塞泵/doc/RESULT_rotor.md

# sub-rotor 交付报告 — BP-02 偏心轴 / BP-05 配流盘

依据：`spec/DESIGN_SPEC.md` §1/§3.2/§3.5/§8 + Lead v1.1 更正 #2（腰型窗 160°/20°，岛跨 ±X）+ Lead 三条裁决（A/B/C）
SW：SOLIDWORKS 2024 SP5（bridge 0.2.1, pid 41652 → SW pid 40672）
所有回读数字均来自 `sw_build` 的 `model.volume_mm3 / box_mm`、`sw_mass_properties`、`sw_inspect` 与 `sw_probe`，非估算。

> **本版变更（2026-11-01 22:5x）**：按 Lead 裁定 B，BP-02 **取消** z=16 端面 3×Ø3.3（M4）底孔。
> 该特征是「删除」而非「抑制」——桥接器拒绝删除上次会话建的特征（只删本会话建的），故我**整件重建**了一遍（不抑制、不留悬空特征），新树 37 个特征、`with_errors = 0`。
> 体积 26270.860261 → **26474.290684**（= + 203.430423，即三个底孔被取消后回填的材料）。

---

## 1. BP-02 偏心轴

| 项 | 值 |
|---|---|
| 文件 | `C:\Users\谷博康\Documents\dsh-solidworks\pump\BP02_ecc_shaft.sldprt` |
| 大小 / sha256 | **203753 B / `04f4e2ee92059c4ab95e116a9d3e9cb2738b7d149fe323eab85344d4320dcb1e`** |
| 局部坐标 | 轴线 = Z，z ∈ [−13, 80]，总长 **93.000** |
| box_mm | min `[−11.2, −12, −13]` max `[14.5, 12, 80]`，size **25.7 × 24 × 93**（删孔前后**不变**） |
| 最终体积 | **26474.290684 mm³** |
| 实体 / 特征 | 1 个实体，37 个特征，`with_errors = 0` |

### 特征列表（按建序，重建后的实际树）

| # | 特征 | 内容 | 体积回读 mm³ |
|---|---|---|---|
| 1 | 凸台-拉伸1 | Ø16（r8），z −13→−3，L10 | 2010.619（理论 2010.619）※首版 |
| 2 | 凸台-拉伸2 | Ø13（r6.5），z −3→−1，L2（退刀槽） | 7616.791389（本次实测，与首版逐位相同） |
| 3 | 凸台-拉伸3 | Ø20（r10），z −1→16，L17 | 同上 |
| 4 | 凸台-拉伸4 | **Ø24（r12），中心 (+2.5, 0)，z 16→28，L12（e₁=2.5 +X）** | 26667.40924（本次实测） |
| 5 | 凸台-拉伸5 | Ø20，z 28→40，L12 | 同上 |
| 6 | 凸台-拉伸6 | **Ø20，中心 (−1.2, 0)，z 40→52，L12（e₂=1.2 −X）** | 同上 |
| 7 | 凸台-拉伸7 | Ø20，z 52→56，L4 | 同上 |
| 8 | 凸台-拉伸8 | Ø16（r8），z 56→80，L24（上轴颈/输出端） | 同上（8 段毛坯总 26667.409，理论 26667.41） |
| 9 | 切除-拉伸1 | 键槽 4×2.5 ×L8，z −12→−4，+X 母线，槽底平面 x=5.5 | 26512.793725（去 154.62） |
| 10 | 切除-拉伸2 | 键槽 4×2.5 ×L8，z 70→78，+X 母线 | 同上 |
| ~~11~~ | ~~3×Ø3.3 底孔~~ | **已按 Lead 裁定 B 取消**（该特征不存在；原去除 203.430423 mm³） | — |
| 12 | 倒角1 | C1 ×2（z=−13、z=80 端外圆棱边） | — |
| 13 | 圆角1 | R1 ×3（轴肩 z=−1、z=−3、z=56） | **26474.290684** |
| — | 参考基准面 ×10 | P_zm13/P_zm3/P_zm1/P_z16/P_z28/P_z40/P_z52/P_z56/P_zm12/P_z70 | — |

体积链（本次重建逐点实测）：26667.40924 →（两键槽 −154.62）→ 26512.793725 →（C1×2 + R1×3）→ **26474.290684**

### 偏心量实测（sw_probe，本项目关键验收点；重建后复测）

| 项 | 实测 |
|---|---|
| Ø24 工作偏心轮 | 外圆柱面 **Ø24.000**，`axis_point_mm = [2.5, 0, 28]` ⇒ **e₁ = +2.500 mm（+X）** |
| 同圆柱 +X/−X 两侧点 | `[14.5, 0, 22]` 与 `[−9.5, 0, 22]` 同面，间距 **24.000** = 直径；两侧半径均 12.000 |
| Ø20 平衡偏心段 | 外圆柱面 **Ø20.000**，`axis_point_mm = [−1.2, 0, 52]` ⇒ **e₂ = −1.200 mm（−X）** |
| 同圆柱两侧点 | `[8.8, 0, 46]` 与 `[−11.2, 0, 46]` 同面，间距 **20.000**；两侧半径均 10.000 |
| 偏心量交叉校验 | (0,12,22) 到轮心距 −12 = 0.2577 → probe `off_by = 0.257651` |

### 键槽实测（重建后复测）
- 下键槽底面平面：`x = 5.5`（Ø16 半径 8 − 深 2.5），box `[5.5,−2,−12]`–`[5.5,2,−4]`，面面积 **32.00** = 4×8 ✔
- 上键槽底面平面：`[5.5,−2,70]`–`[5.5,2,78]`，面面积 **32.00** ✔
- Ø16 圆柱面被切到 max x 7.745967（<8）→ 键槽确在 **+X 母线** ✔

### 底孔状态（变更项）
- z=16 端面 **已无任何孔**。证据：`(7.35, 0, 20)` 现在落在「凸台-拉伸3」（Ø20，z −1..16）的圆柱面上、`off_by = 4.798177`（点在实体内，即该处无孔）；删孔前同一点返回 Ø3.3 圆柱面（3 棱边、82.94 mm²）。
- 特征树中不再存在该切除特征（只有两处键槽切除），因此是真正移除，不是抑制。

---

## 2. BP-05 配流盘（2026-11-02 已加上端面 Ø21×1 沉孔）

| 项 | 值 |
|---|---|
| 文件 | `C:\Users\谷博康\Documents\dsh-solidworks\pump\BP05_portplate.sldprt` |
| 大小 / sha256 | **169031 B / `cf532b0a3cdabb119f1f9e3770da0004e689c40a54c0f1604a4794824dc2aa43`** |
| 局部坐标 | 轴线 = Z，z ∈ [0, 10]（装配 [0,0,−10] → 占 −10..0，符合 §7） |
| box_mm | min `[−32, −32, 0]` max `[32, 32, 10]`，size **64 × 64 × 10**（加沉孔前后不变） |
| 最终体积 | **19501.866475 mm³**（加沉孔前 19618.731866；C0.5 前 19763.608701；解析理论 19763.603） |

### 特征列表

| # | 特征 | 内容 |
|---|---|---|
| 1 | 凸台-拉伸1 | Ø64 × 10，z 0→10（体积 32169.909，理论 32169.909） |
| 2 | 切除-拉伸1 | 中心孔 Ø16.5 通（`axis Ø16.500`，去 2138.25） |
| 3 | 切除-拉伸3 | 键槽 4×2.5，+X 母线，槽底平面 **x=10.75**（去 103.26） |
| 4 | 切除-拉伸4 | 腰型窗 A：α ∈ [10°, 170°]，R22.5→R29.5，通（去 **5082.38**，理论 5082.40） |
| 5 | 切除-拉伸5 | 腰型窗 B：α ∈ [190°, 350°]，R22.5→R29.5，通（去 **5082.38**） |
| 6 | 倒角1 | z=10 面全部棱边 C0.5（去 72.44） |
| 7 | 倒角2 | z=0 面全部棱边 C0.5（去 72.44） |
| 8 | 切除-拉伸6 | **上端面 Ø21×1 沉孔（局部 z 9→10，与 Ø16.5 同心）**，让偏心轴 Ø20 在全局 z −1→0 落进沉孔（径向间隙 0.5），消除原 86.805 mm³ 干涉（去 **116.865**） |

体积链：32169.909 −2138.25 −103.26 −5082.38 −5082.38 = **19763.609** → 两面 C0.5 → **19618.731866** → Ø21×1 沉孔 −**116.865391** → **19501.866475**

### 沉孔体积对账（2026-11-02，Lead 预期 ≈19486.2，实测更高，原因已定）
- 理论整环（π/4×(21²−16.5²)×1）= **132.5359**；实测去除 **116.8654**
- 差值 **15.6705** = 环带里**早已被别的特征去掉的料**，沉孔不再重复去除：
  - 键槽在 r 8.25→10.5、|y|≤2 处占去 **9.3261**（该处本已是空腔）
  - 孔口 C0.5 倒角环（r 8.25→8.75、z 9.5→10，三角环 2π·8.4167·0.125）占去 **6.6104**
  - 两者重叠（键槽段内的倒角）**−0.2660**
  - 合计 **15.6705** ✔
- 独立复核：按「每个 z 上环带内原有材料面积」数值积分得去除 **116.8674**，与实测 **116.8654** 相差 **−0.002 mm³**（0.002%）
- 沉孔底面积实测 **123.463 mm²** = 整环 132.536 − 键槽开口 9.07（积分预测 123.465，一致）
- 新体积 = 19618.731866 − 116.865391 = **19501.866475**（与积分预测 19501.8645 差 0.002）

### 腰型窗角度实测（关键验收点）

| 项 | 实测 | 判定 |
|---|---|---|
| 内弧面 | 圆柱 **Ø45.000068** ⇒ 内 R22.500 | ✔ |
| 外弧面 | 圆柱 **Ø58.999923** ⇒ 外 R29.500（径向宽 7.000） | ✔ |
| 窗 A 径向边 1 | 平面 box x 22.1582→29.0518、y 3.9071→5.1226 ⇒ α = atan(3.9071/22.1582) = **10.000°** | ✔ |
| 窗 A 径向边 2 | 平面 x −29.0518→−22.1582、y 3.9071→5.1226 ⇒ α = **170.000°** | ✔ |
| 窗 B 径向边 1 | 平面 x −29.0518→−22.1582、y −5.1226→−3.9071 ⇒ α = **190.000°** | ✔ |
| 窗 B 径向边 2 | 平面 x 22.1582→29.0518、y −5.1226→−3.9071 ⇒ α = **350.000°** | ✔ |
| 包角 | 170 − 10 = **160.000°**；350 − 190 = **160.000°** | ✔ |
| 岛角 | [−10°, 10°] 与 [170°, 190°]，各 **20.000°**（岛中心线在 α=0°/180°） | ✔ |
| 体积反算 | 单窗去除 5082.38 mm³ vs 理论 ½·2.79253·(29.5²−22.5²)·10 = 5082.40（偏差 0.0004%） | ✔ |
| 径向边面积 | 62.999 / 69.999 mm²（含/不含 C0.5）= 7（宽）×10（厚） | ✔ |

**结论：腰型窗 = R22.5/R29.5、包角 160°、岛 20°、岛跨 ±X，与 Lead v1.1 定稿一致。**

### 腰型窗坐标（实际填入 sketch 的值，与 `data/portplate_geometry.md` 一致；独立复算到 1e-4 一致）

窗 A（压油，+Y 侧）
```
内弧 arc:  from ( 22.1582,  3.9071)  through ( 0, 22.5)  to (−22.1582,  3.9071)
径向线  :  (−22.1582, 3.9071) → (−29.0518, 5.1226)
外弧 arc:  from (−29.0518,  5.1226)  through ( 0, 29.5)  to ( 29.0518,  5.1226)
径向线  :  ( 29.0518, 5.1226) → ( 22.1582, 3.9071)      [闭合]
```
窗 B（吸油，−Y 侧）
```
内弧 arc:  from (−22.1582, −3.9071)  through ( 0,−22.5)  to ( 22.1582, −3.9071)
径向线  :  ( 22.1582, −3.9071) → ( 29.0518, −5.1226)
外弧 arc:  from ( 29.0518, −5.1226)  through ( 0,−29.5)  to (−29.0518, −5.1226)
径向线  :  (−29.0518, −5.1226) → (−22.1582, −3.9071)    [闭合]
```
关键点半径校验：22.1582² + 3.9071² = 490.98 = 22.5²；29.0518² + 5.1226² = 870.30 = 29.5²。

### 键槽实测
- 槽底面：平面 `x = 10.75`（顶点 8.25 + 2.5），宽 4（y ±2）；面 40.01 = 4×10（C0.5 后 36.008）
- 过程记录：首版误把矩形远边放在 x=11，实测槽深 2.75、去 113.30；已删除重建为 10.75/103.26。

---

## 3. 裁决与偏差台账（Lead 已裁定，均不再待办）

### A — 回程盘装不进 → **裁定：BP-04 改为「泵体上端封压盘」**
我的诊断成立，Lead 进一步证明其更严重（几何无解，非参数问题）：沉头螺钉要进 Ø24 偏心轮则孔只能在 R9、沉头 Ø8 占 R5~R13；而中心孔又必须 ≥Ø30 才能越过 Ø29 偏心轮包络 → 沉头孔落在孔内无材料；孔缩到 Ø20 又越不过 Ø24/Ø20 偏心段。
**裁定：BP-04 不随轴转，改为 Ø104×6 封压盘（装配 z 56→62，中心孔 Ø20，上表面球面 R40 凸于 Ø60 范围，3×沉头 Ø5.5/Ø10 @Ø88 0/120/240，下表面 Ø78 密封槽，M5×30 压紧）；回程力由 3 个柱塞弹簧独立提供，弹簧座仍在柱塞孔底 R48。**
→ BP-04 属 sub-plunger 写域，我未改动该件。

### B — M4 底孔破出 → **裁定：3 个孔直接取消，已在 BP-02 上执行完毕**
回程盘改壳体装后，偏心轮端面不再需要 3×M4，破出问题随需求消失。**BP-02 已删该特征并重存**（见 §1 变更项），其余尺寸一律未动。
> 一处数字校正：Lead 预估「26270.86 → ≈26066」，方向是反的——删除切除特征会**回填**材料。正确预期 = 26270.860261 **+** 203.430423 = **26474.290684**（实测正是此值）。孔体积比 3×π×1.65²×8 = 205.27 少 1.84，正是那 0.126 mm 破出所没切到的材料。

### C — 材料未赋 → **裁定：不追，作「已知偏差」**
两件 `material = null`、`density = 1000 kg/m³`（SW 默认水），故 `mass_kg`（0.026474 / 0.019619）**无工程意义**，不得引用为设计质量。桥接器无赋材料接口（`sw_edit` 只能写自定义属性），已确认属能力限制。材料在工程图明细栏（BOM）标注：BP-02 = 45 钢调质 HB220~250，BP-05 = ZQSn6-6-3 锡青铜。

### D — 未注圆角 R0.8 → **裁定：保持现状，不补**
**「未注圆角 R0.8 由图纸技术要求统一规定，三维模型不逐边实现，以免破坏键槽与孔口功能尺寸。」**
（偏心轴已做 C1×2 端倒角 + R1×3 轴肩圆角；配流盘两面各做 C0.5，覆盖两面全部外露棱边。）

### E — 表面质量无法建模
配流面 Ra0.4、平面度/平行度 0.005、腰型窗位置度 Ø0.05 等属图纸标注项，SW 实体模型不承载，须由 AutoCAD 子任务在零件图上标注。

### 备注（对其他 SW 子任务有用）
1. **`sw_build` 的 cut 默认沿 −Z 切除**（不是沿草图法向 +Z）。z=0 平面上的切除要显式 `reverse: true` 才向 +Z 切；反之从 z=−12 平面向 +Z 切也要 `reverse: true`。我第一版两处键槽就因此切反（只切掉 1 mm），已删重建。
2. 在**命名基准面**上画草图时，实体坐标必须给 `[x, y, z]` 三点式，只给 `[x, y]` 会报 `center must be [x, y, z]`。
3. SW 的 `top` 视图对 Z 轴零件看到的是**侧视**；要看盘面用 `front` 视图。
4. **`sw_build` 的 `delete` 只删「本桥接会话内建的特征」**：文档一旦关闭重开，旧特征就删不掉（报 `was not made by sw_build in this bridge session`）。要真正删特征只能在同一会话内删，或整件重建（`suppress` 会在树里留被抑制特征，不等于删除）。

---

## 4. 验收测试运行记录（磁盘回读；本工程无测试套件的等效测试）

> 方法：**关闭文档 → 以只读方式从磁盘重开 → 回读体积/包围盒/probe 几何**逐项对照期望值。验证已落盘的文件，不是内存态。
> 共两轮：第一轮 22:44（删孔前）、第二轮 22:5x（删孔后重建）。

### BP-02 偏心轴 · 第二轮（删孔后，文件 203753 B，重开 2.03 s，37 特征，`with_errors = 0`）

| # | 断言 | 期望 | 实测 | 判定 |
|---|---|---|---|---|
| 1 | 落盘体积 | 26474.290684（= 旧 26270.860261 + 203.430423） | 26474.290684（`sw_mass_properties`） | **PASS** |
| 2 | 包围盒不变 | 25.7 × 24 × 93，z −13..80 | `[−11.2,−12,−13]`–`[14.5,12,80]` | **PASS** |
| 3 | 实体数 / 重建错误 | 1 / 0 | 1 / 0 | **PASS** |
| 4 | **3×Ø3.3 底孔已不存在** | 该处为实体 | (7.35,0,20) → Ø20 圆柱面，`off_by 4.798177`（删孔前为 Ø3.3、3 棱边） | **PASS** |
| 5 | 特征树无该切除特征 | 无 | 树中仅 切除-拉伸1/2（两键槽） | **PASS** |
| 6 | e₁ 偏心轮 | Ø24.000，轴线 x=+2.500 | Ø24，`axis_point=[2.5,0,28]`，box x −9.5..14.5 | **PASS** |
| 7 | e₂ 平衡段 | Ø20.000，轴线 x=−1.200 | Ø20，`axis_point=[−1.2,0,52]`，box x −11.2..8.8 | **PASS** |
| 8 | 偏心量交叉校验 | (0,12,22) 距轮心 −12 = 0.2577 | `off_by = 0.257651` | **PASS** |
| 9 | 下键槽 | 底 x=5.5、宽 4、z −12..−4 | 面 32.00=4×8，box `[5.5,−2,−12]`–`[5.5,2,−4]` | **PASS** |
| 10 | 上键槽 | 底 x=5.5、宽 4、z 70..78 | 面 32.00，box `[5.5,−2,70]`–`[5.5,2,78]` | **PASS** |
| 11 | 键槽在 +X 母线 | Ø16 圆柱被切到 max x 7.746 | 圆柱面 box x −8..7.745967 | **PASS** |
| 12 | 各段直径/退刀槽未变 | 8 段毛坯 = 理论 26667.41 | 26667.40924 | **PASS** |
| 13 | C1/R1 未丢 | 倒角1、圆角1 生效 | 26512.793725 −38.503041 = 26474.290684 | **PASS** |

### BP-05 配流盘 · 第一轮（22:44，文件 154003 B，重开 2.09 s，`solid_bodies = 1`）

| # | 断言 | 期望 | 实测 | 判定 |
|---|---|---|---|---|
| 1 | 落盘体积 | 19618.731866 | 19618.731866（`sw_mass_properties`） | **PASS** |
| 2 | 包围盒 | 64 × 64 × 10，z 0..10 | `[−32,−32,0]`–`[32,32,10]` | **PASS** |
| 3 | 外径 | Ø64 | Ø64，面 1809.557 | **PASS** |
| 4 | 中心孔 | Ø16.5 通 | Ø16.5，box z 0.5..9.5（倒角后） | **PASS** |
| 5 | 内弧 | Ø45.000（R22.5） | Ø45.000068 | **PASS** |
| 6 | 外弧 | Ø59.000（R29.5） | Ø58.999923 | **PASS** |
| 7 | 窗 A 径向边 | α=10.000° / 170.000° | 平面 box x 22.1582..29.0518, y 3.9071..5.1226 → 10.000° | **PASS** |
| 8 | 窗 B 径向边 | α=190.000° / 350.000° | 平面 box y −5.1226..−3.9071 → 190.000° / 350.000° | **PASS** |
| 9 | 岛在 ±X | α=0 处 r=26 为实体 | (26,0,10) 落在 z=10 顶面（面 1685.92、13 棱边） | **PASS** |
| 10 | 窗在 ±Y | α=90/270 处 r=26 为空洞 | (0,±26,10) 无顶面，off_by 3.535534 = 29.5−26 | **PASS** |
| 11 | 键槽 | 底 x=10.75、宽 4 | 平面 box `[10.75,−2.000919,0.5]`–`[10.75,2,9.5]` | **PASS** |
| 12 | C0.5 生效 | 两面棱边 0.5 | 全部窗口/孔面 box z 0.5..9.5 | **PASS** |

**测试结论：BP-02 第二轮 13 项 + BP-05 第一轮 12 项 = 25 项断言全部 PASS，0 FAIL。**
