GBK-com/Delumenyu/小型偏心柱塞泵/cad/BP00_装配图.pdf

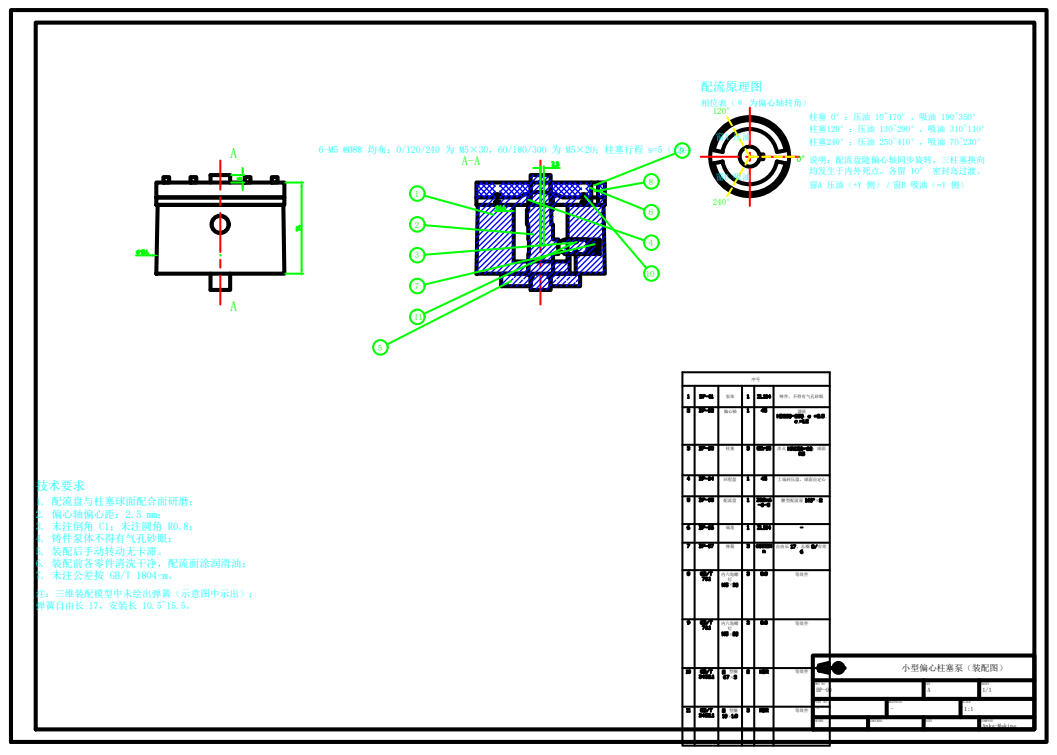
[picture p17: page 1]
小型偏心柱塞泵（装配图） DWG NO BP-00; REVA; SHEET 1/1 PART NO -; MATERIAL -; SCALE 1:1 DRAWN; CHECKED; DATE; COMPANY Anka-Makine 123; 6-M5 @Ø88 均布：0/120/240 为 M5×30，60/180/300 为 M5×20；柱塞行程 s=5（=2e） 11; 铸件，不得有气孔砂眼 偏心轴; ；球面 回程盘; 上端封压盘，球面自定心 配流盘; 腰型配流窗; × 端盖弹簧; 自由长; 有效 内六角螺 钉×; 等效件 内六角螺 钉×; 等效件 型圈×; 等效件 型圈 ×; 等效件 技术要求 1. 配流盘与柱塞球面配合面研磨； 2. 偏心轴偏心距：2.5 mm； 3. 未注倒角 C1；未注圆角 R0.8； 4. 铸件泵体不得有气孔砂眼； 5. 装配后手动转动无卡滞。 6. 装配前各零件清洗干净，配流面涂润滑油； 7. 未注公差按 GB/T 1804-m。 注：三维装配模型中未绘出弹簧（示意图中示出）； 弹簧自由长 17，安装长 10.5~15.5。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
