GBK-com/Delumenyu/小型偏心柱塞泵/cad/BP02_偏心轴.pdf

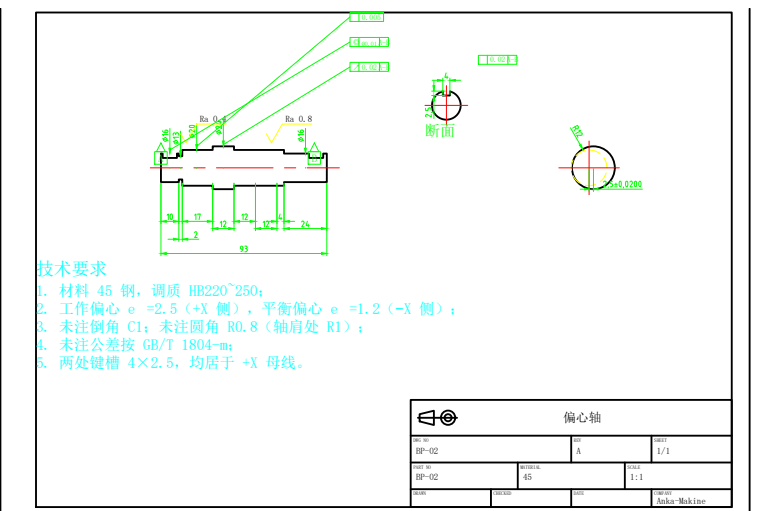
[picture p19: page 1]
偏心轴 DWG NO BP-02; REVA; SHEET 1/1 PART NO BP-02; MATERIAL 45; SCALE 1:1 DRAWN; CHECKED; DATE; COMPANY Anka-Makine 断面 0.005 ◎; 0.02 A-B Ø0.01 技术要求 1. 材料 45 钢，调质 HB220~250； 2. 工作偏心 e =2.5（+X 侧），平衡偏心 e =1.2（−X 侧）； 3. 未注倒角 C1；未注圆角 R0.8（轴肩处 R1）； 4. 未注公差按 GB/T 1804-m； 5. 两处键槽 4×2.5，均居于 +X 母线。
