GBK-com/Delumenyu/小型偏心柱塞泵/cad/BP05_配流盘.pdf

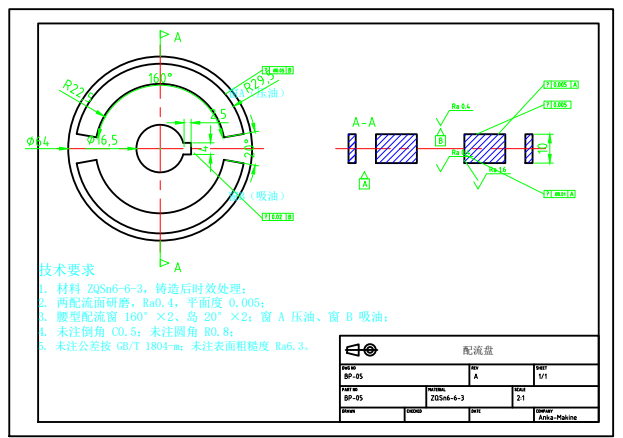
[picture p20: page 1]

技术要求
1. 材料 ZQSn6-6-3，铸造后时效处理；
2. 两配流面研磨，Ra0.4，平面度 0.005；
3. 腰型配流窗 160°×2、岛 20°×2；窗 A 压油、窗 B 吸油；
4. 未注倒角 C0.5；未注圆角 R0.8；
5. 未注公差按 GB/T 1804-m；未注表面粗糙度 Ra6.3。
