GBK-com/Delumenyu/(commit log)

2026-11-01 初始化仓库：添加 README
2026-11-02 新增：小型偏心柱塞泵完整工程包
    - SW 模型 15 个（8 类零件 + 总装 + 运动版 + 标准件）
    - 工程图 4 张 × (DWG/DXF/PDF)：装配图A1、泵体/偏心轴/配流盘 A3
    - 设计书 v1.3、偏差登记 13 条、运动学表、配流盘坐标、交付报告
    - 干涉检查真设计干涉 0 项；运动仿真 SW Motion Study 已求解；图纸回归 48/48
    [BP00_装配图.dwg, BP00_装配图.dxf, BP01_housing.SLDPRT, BP01_泵体.dwg, BP01_泵体.dxf, BP02_ecc_shaft.SLDPRT, BP02_偏心轴.dwg, BP02_偏心轴.dxf]
2026-11-02 文档：README 改写为模型库总索引，新增 .gitignore
